awtoau/awto-cynthion-hardware/cynthion.kicad_pcb

## KiCad design cynthion.kicad_pcb (2026-07-26)

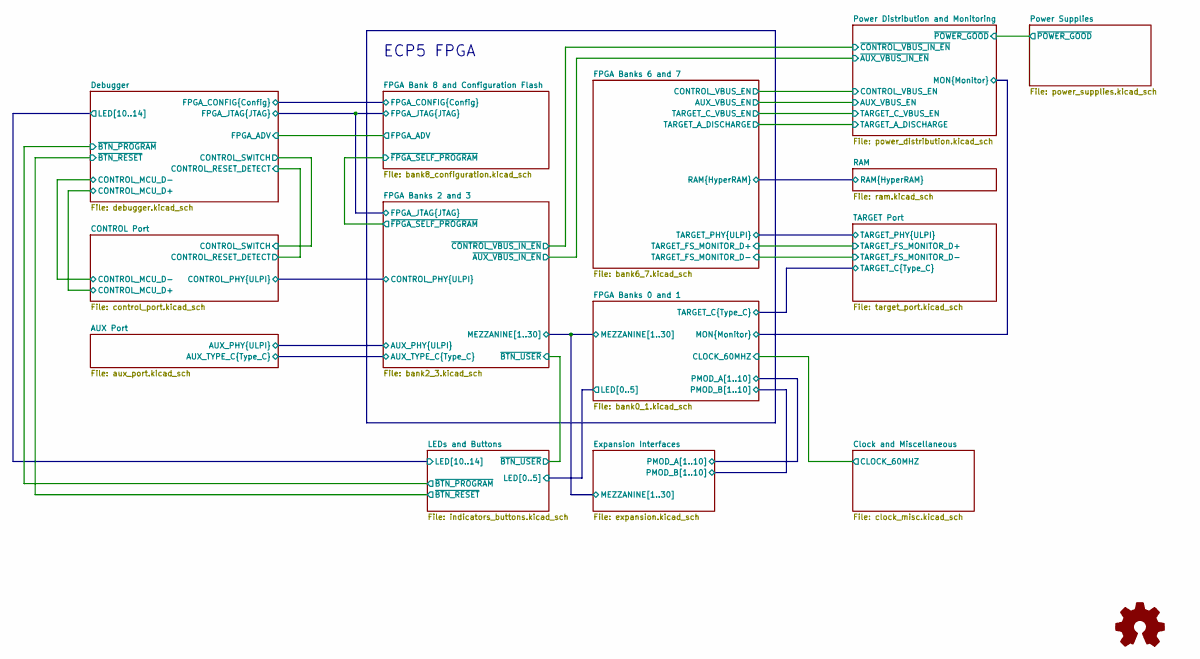
[picture p1: schematic cynthion.kicad_sch, ${TITLE}]

Notes on the sheet:
ECP5 FPGA

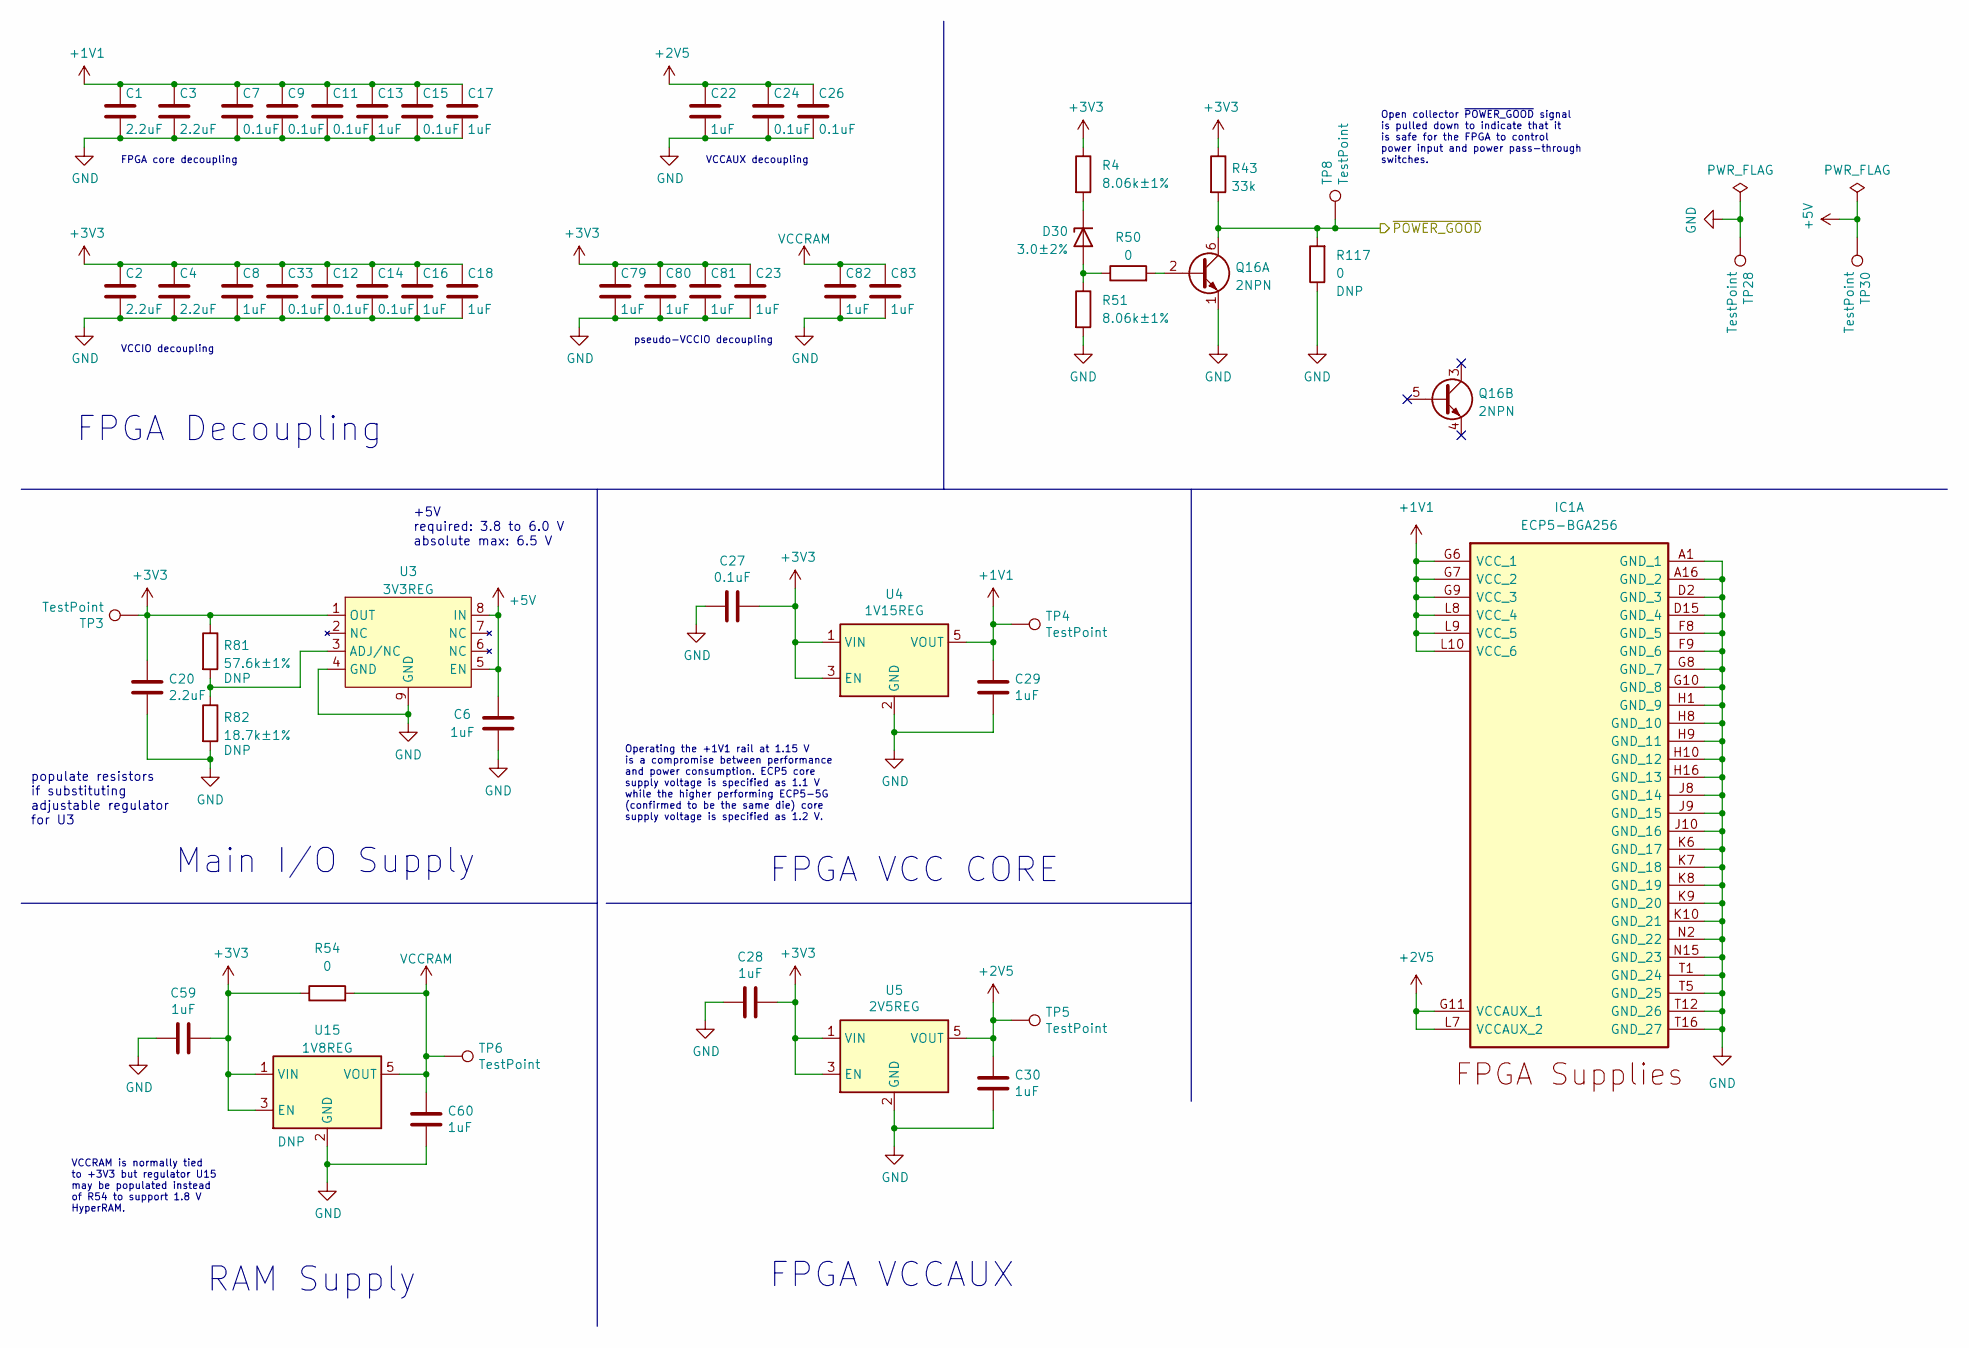
[picture p2: schematic power_supplies.kicad_sch, ${TITLE}]

Parts:
C1, C2, C3, C4, C20: 2.2uF; C_0603_1608Metric; Part Number CL10A225KP8NNNC
C6, C8, C13, C16, C17, C18, C22, C23, C28, C29, C30, C59, C60, C79, C80, C81, C82, C83: 1uF; C_0402_1005Metric; Part Number CL05A105MQ5NNNC
C7, C9, C11, C12, C14, C15, C24, C26, C27, C33: 0.1uF; C_0402_1005Metric; Part Number CL05A104KA5NNNC
D30: 3.0±2%; DFN1006-2; Part Number BZX884-B3V0,315
IC1: ECP5-BGA256; lattice_cabga256; Part Number LFE5U-12F-6BG256C
Q16: 2NPN; SOT-363_SC-70-6; Part Number BC847BS
R4, R51: 8.06k±1%; R_0402_1005Metric; Part Number ERJ-2RKF8061X
R43: 33k; R_0402_1005Metric; Part Number ERJ-2GEJ333X
R50, R54, R117: 0; R_0402_1005Metric; Part Number RC0402FR-070RL
R81: 57.6k±1%; R_0402_1005Metric; Part Number RC0402FR-0757K6L
R82: 18.7k±1%; R_0402_1005Metric; Part Number ERJ-2RKF1872X
TP3, TP4, TP5, TP6, TP8, TP28, TP30: TestPoint; TestPoint_Pad_D1.0mm
U3: 3V3REG; DFN-8-1EP_3x3mm_P0.65mm_EP1.55x2.4mm; Part Number AP7361EA-33FGE-7
U4: 1V15REG; SOT-23-5; Part Number TCR2EF115,LM(CT
U5: 2V5REG; SOT-23-5; Part Number MIC5504-2.5YM5-TR
U15: 1V8REG; SOT-23-5; Part Number MIC5504-1.8YM5-TR

Connections:
+1V1: C1.1, C3.1, C7.1, C9.1, C11.1, C13.1, C15.1, C17.1, C29.1, IC1.G6 (VCC_1), IC1.G7 (VCC_2), IC1.G9 (VCC_3), IC1.L8 (VCC_4), IC1.L9 (VCC_5), IC1.L10 (VCC_6), TP4.1 (1_1), U4.5 (VOUT)
+2V5: C22.1, C24.1, C26.1, C30.1, IC1.G11 (VCCAUX_1), IC1.L7 (VCCAUX_2), TP5.1 (1_1), U5.5 (VOUT)
+3V3: C2.1, C4.1, C8.1, C12.1, C14.1, C16.1, C18.1, C20.1, C23.1, C27.1, C28.1, C33.1, C59.1, C79.1, C80.1, C81.1, R4.1, R43.1, R54.1, R81.1, TP3.1 (1_1), U3.1 (OUT), U4.1 (VIN), U4.3 (EN), U5.1 (VIN), U5.3 (EN), U15.1 (VIN), U15.3 (EN); also elsewhere on the board
+5V: C6.1, TP30.1 (1_1), U3.5 (EN), U3.8 (IN); also elsewhere on the board
/Power Distribution and Monitoring/~POWER_GOOD: Q16.6 (C1), R43.2, R117.2, TP8.1 (1_1); also elsewhere on the board
GND: C1.2, C2.2, C3.2, C4.2, C6.2, C7.2, C8.2, C9.2, C11.2, C12.2, C13.2, C14.2, C15.2, C16.2, C17.2, C18.2, C20.2, C22.2, C23.2, C24.2, C26.2, C27.2, C28.2, C29.2, C30.2, C33.2, C59.2, C60.2, C79.2, C80.2, C81.2, C82.2, C83.2, IC1.A1 (GND_1), IC1.A16 (GND_2), IC1.D2 (GND_3), IC1.D15 (GND_4), IC1.F8 (GND_5), IC1.F9 (GND_6), IC1.G8 (GND_7), IC1.G10 (GND_8), IC1.H1 (GND_9), IC1.H8 (GND_10), IC1.H9 (GND_11), IC1.H10 (GND_12), IC1.H16 (GND_13), IC1.J8 (GND_14), IC1.J9 (GND_15), IC1.J10 (GND_16), IC1.K6 (GND_17), IC1.K7 (GND_18), IC1.K8 (GND_19), IC1.K9 (GND_20), IC1.K10 (GND_21), IC1.N2 (GND_22), IC1.N15 (GND_23), IC1.T1 (GND_24), IC1.T5 (GND_25), IC1.T12 (GND_26), IC1.T16 (GND_27), Q16.1 (E1), R51.2, R82.2, R117.1, TP28.1 (1_1), U3.4 (GND), U3.9 (GND), U4.2 (GND), U5.2 (GND), U15.2 (GND); also elsewhere on the board
unnamed: D30.2 (A), R50.1, R51.1
unnamed: D30.1 (K), R4.2
unnamed: Q16.2 (B1), R50.2
unnamed: R81.2, R82.1, U3.3 (ADJ/NC)
VCCRAM: C60.1, C82.1, C83.1, R54.2, TP6.1 (1_1), U15.5 (VOUT); also elsewhere on the board

Notes on the sheet:
VCCIO decoupling
FPGA VCC CORE
FPGA Decoupling
FPGA core decoupling
+5V required: 3.8 to 6.0 V absolute max: 6.5 V
VCCRAM is normally tied to +3V3 but regulator U15 may be populated instead of R54 to support 1.8 V HyperRAM.
Open collector ~{POWER_GOOD} signal is pulled down to indicate that it is safe for the FPGA to control power input and power pass-through switches.
VCCAUX decoupling
FPGA VCCAUX
Main I/O Supply
populate resistors if substituting adjustable regulator for U3
RAM Supply
Operating the +1V1 rail at 1.15 V is a compromise between performance and power consumption. ECP5 core supply voltage is specified as 1.1 V while the higher performing ECP5-5G (confirmed to be the same die) core supply voltage is specified as 1.2 V.
pseudo-VCCIO decoupling

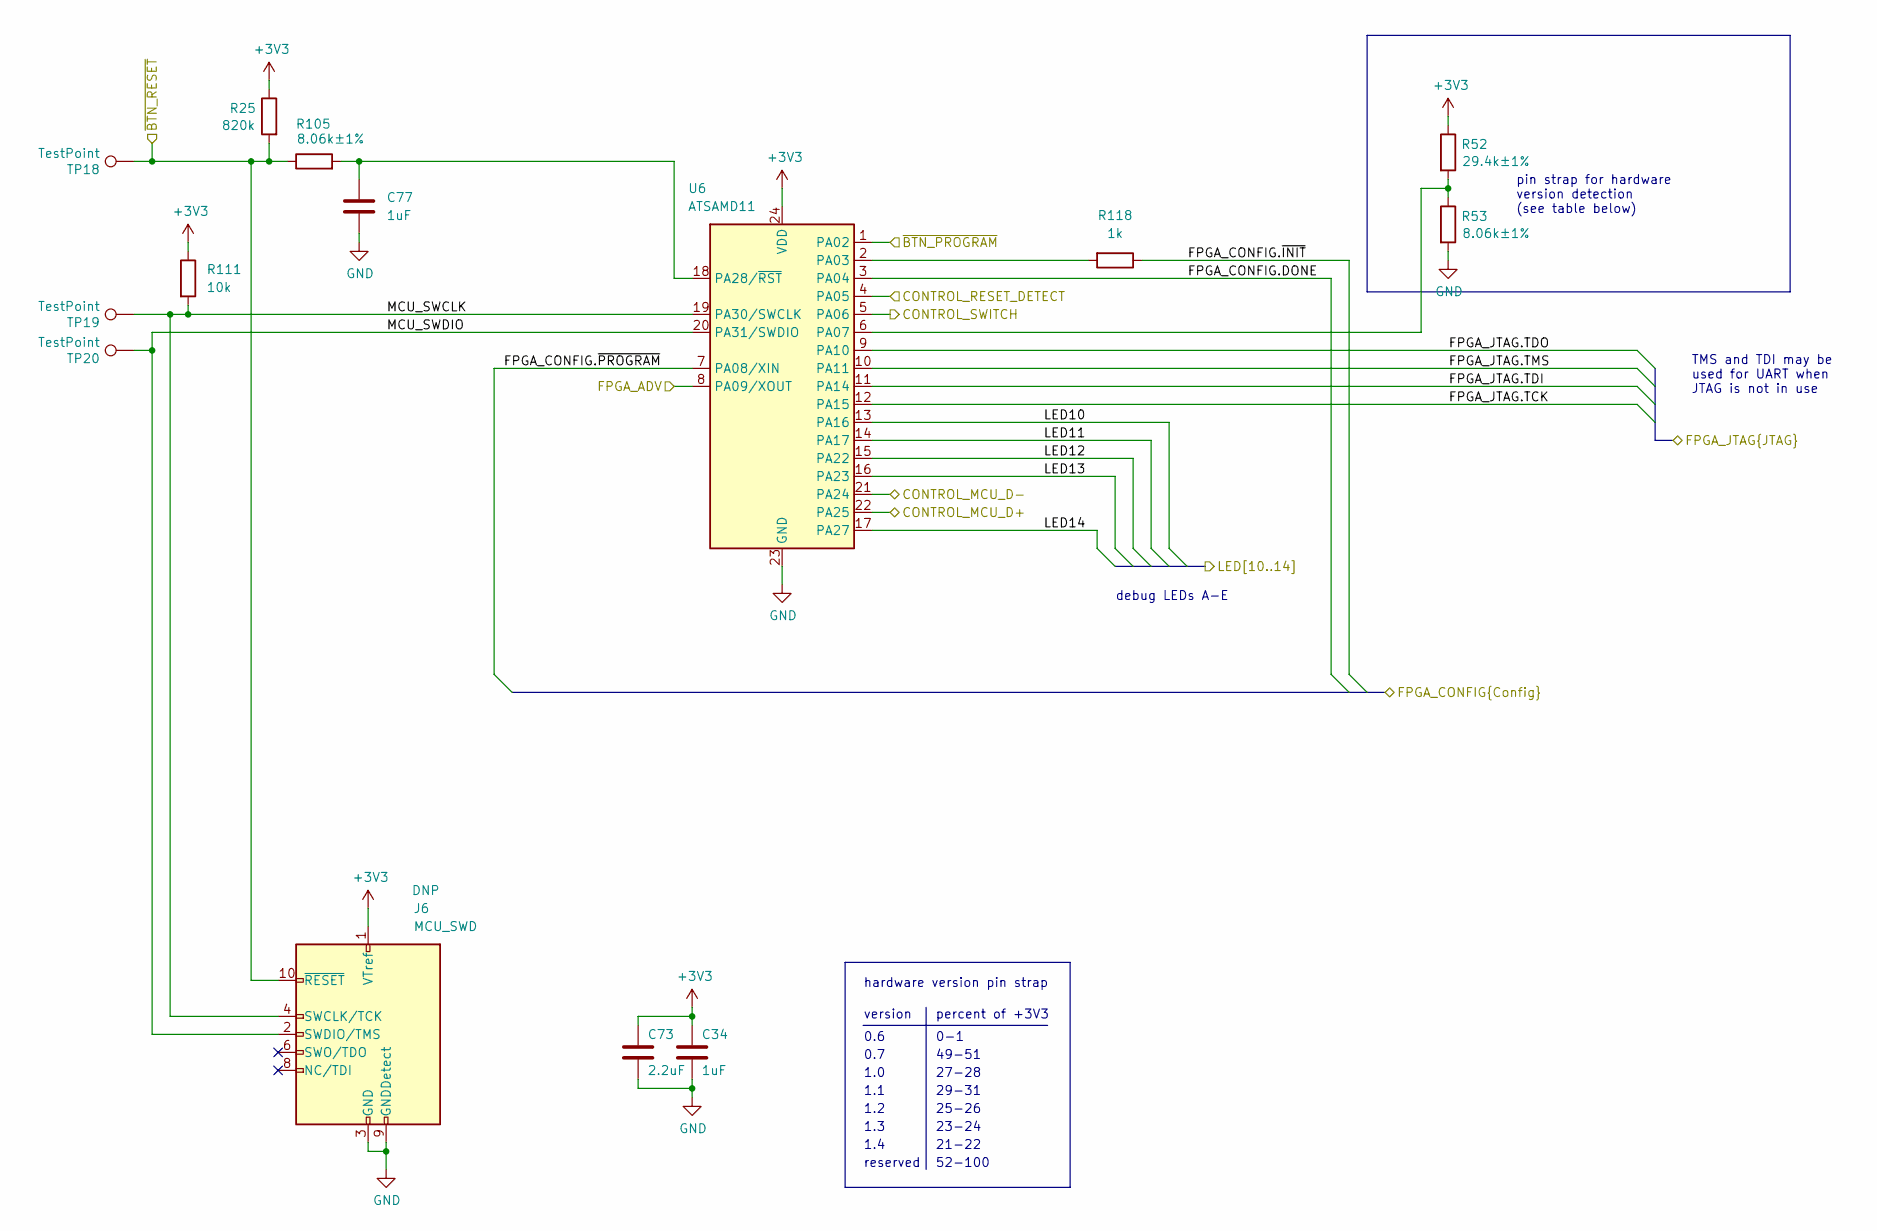
[picture p3: schematic debugger.kicad_sch, ${TITLE}]

Parts:
C34, C77: 1uF; C_0402_1005Metric; Part Number CL05A105MQ5NNNC
C73: 2.2uF; C_0603_1608Metric; Part Number CL10A225KP8NNNC
J6: MCU_SWD; SWD_CONNECTOR_LARGE_BOX; Part Number FTSH-105-01-F-D-K
R25: 820k; R_0402_1005Metric; Part Number RC0402JR-07820KL
R52: 29.4k±1%; R_0402_1005Metric; Part Number RC0402FR-0729K4L
R53, R105: 8.06k±1%; R_0402_1005Metric; Part Number ERJ-2RKF8061X
R111: 10k; R_0402_1005Metric; Part Number RC0402JR-0710KL
R118: 1k; R_0402_1005Metric; Part Number RC0402JR-071KL
TP18, TP19, TP20: TestPoint; TestPoint_Pad_D1.0mm
U6: ATSAMD11; QFN-24-1EP_4x4mm_P0.5mm_EP2.6x2.6mm; Part Number ATSAMD11D14A-MUT

Connections:
+3V3: C34.1, C73.1, J6.1 (VTref), R25.1, R52.1, R111.1, U6.24 (VDD); also elsewhere on the board
/CONTROL Port/CONTROL_MCU_D+: U6.22 (PA25); also elsewhere on the board
/CONTROL Port/CONTROL_MCU_D-: U6.21 (PA24); also elsewhere on the board
/CONTROL Port/CONTROL_RESET_DETECT: U6.4 (PA05); also elsewhere on the board
/CONTROL Port/CONTROL_SWITCH: U6.5 (PA06); also elsewhere on the board
/Debugger/FPGA_ADV: U6.8 (PA09/XOUT); also elsewhere on the board
/Debugger/FPGA_CONFIG.DONE: U6.3 (PA04); also elsewhere on the board
/Debugger/FPGA_CONFIG.~INIT: R118.1; also elsewhere on the board
/Debugger/FPGA_CONFIG.~PROGRAM: U6.7 (PA08/XIN); also elsewhere on the board
/Debugger/FPGA_JTAG.TCK: U6.12 (PA15); also elsewhere on the board
/Debugger/FPGA_JTAG.TDI: U6.11 (PA14); also elsewhere on the board
/Debugger/FPGA_JTAG.TDO: U6.9 (PA10); also elsewhere on the board
/Debugger/FPGA_JTAG.TMS: U6.10 (PA11); also elsewhere on the board
/Debugger/LED10: U6.13 (PA16); also elsewhere on the board
/Debugger/LED11: U6.14 (PA17); also elsewhere on the board
/Debugger/LED12: U6.15 (PA22); also elsewhere on the board
/Debugger/LED13: U6.16 (PA23); also elsewhere on the board
/Debugger/LED14: U6.17 (PA27); also elsewhere on the board
/Debugger/MCU_SWCLK: J6.4 (SWCLK/TCK), R111.2, TP19.1 (1_1), U6.19 (PA30/SWCLK)
/Debugger/MCU_SWDIO: J6.2 (SWDIO/TMS), TP20.1 (1_1), U6.20 (PA31/SWDIO)
/Debugger/~BTN_PROGRAM: U6.1 (PA02); also elsewhere on the board
/Debugger/~BTN_RESET: J6.10 (~RESET), R25.2, R105.1, TP18.1 (1_1); also elsewhere on the board
GND: C34.2, C73.2, C77.2, J6.3 (GND), J6.5 (GND), J6.9 (GNDDetect), R53.2, U6.23 (GND); also elsewhere on the board
unnamed: R118.2, U6.2 (PA03)
unnamed: R52.2, R53.1, U6.6 (PA07)
unnamed: C77.1, R105.2, U6.18 (PA28/~RST)

Notes on the sheet:
1.4
debug LEDs A-E
reserved
27-28
52-100
version
25-26
percent of +3V3
TMS and TDI may be used for UART when JTAG is not in use
29-31
0.6
0-1
1.0
23-24
pin strap for hardware version detection (see table below)
49-51
1.2
0.7
1.3
21-22
1.1
hardware version pin strap

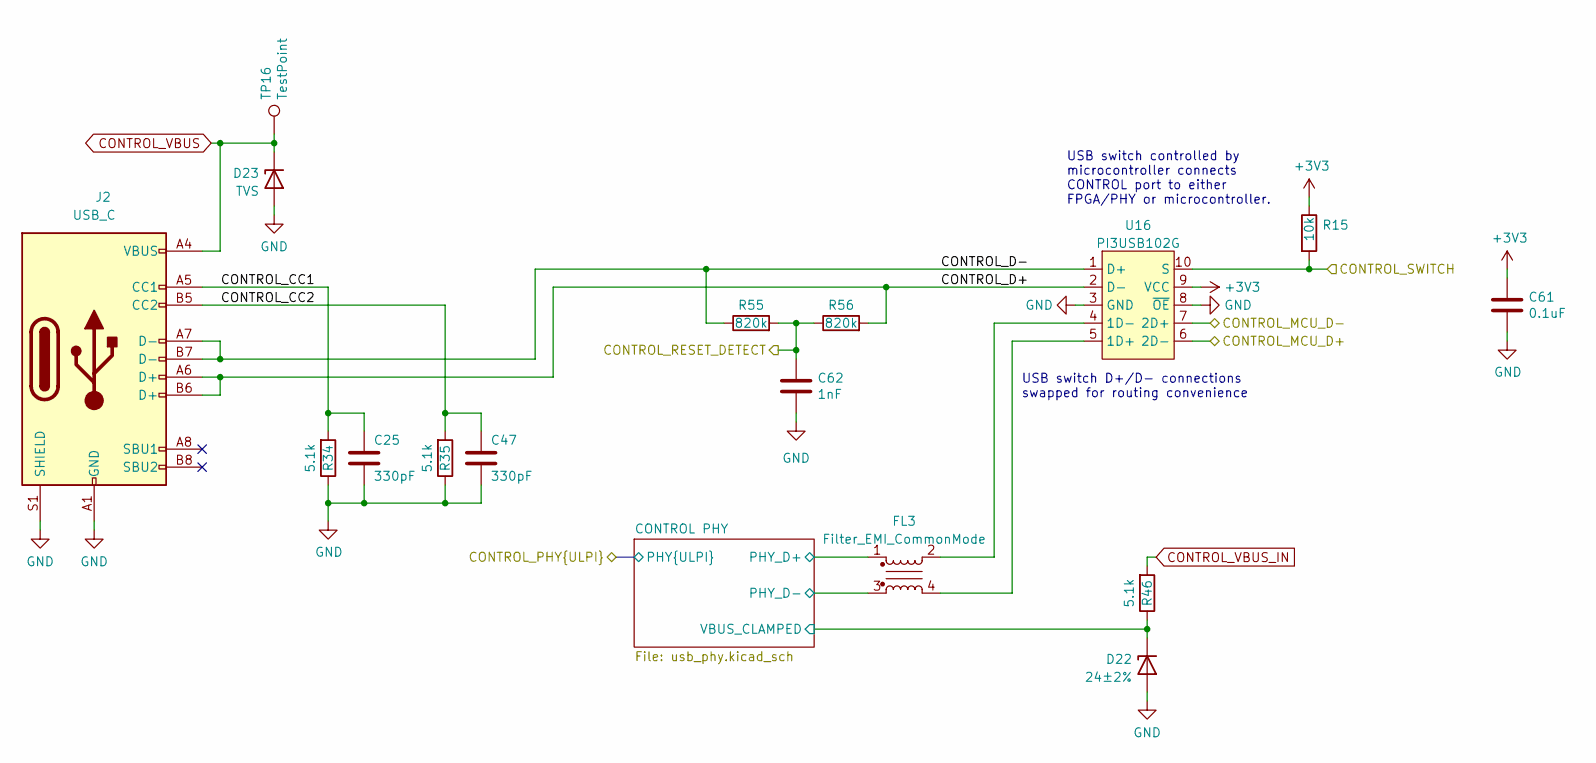
[picture p4: schematic control_port.kicad_sch, ${TITLE}]

Parts:
C25, C47: 330pF; C_0402_1005Metric; Part Number CL05C331JB5NNNC
C61: 0.1uF; C_0402_1005Metric; Part Number CL05A104KA5NNNC
C62: 1nF; C_0402_1005Metric; Part Number CL05B102KB5NNNC
D22: 24±2%; DFN1006-2; Part Number BZX884-B24,315
D23: TVS; DFN1006-2; Part Number PESD36VS1UL,315
FL3: Filter_EMI_CommonMode; L_CommonModeChoke_Murata_DLM0NS; Part Number DLM0NSB280HY2D
J2: USB_C; USB_C_Receptacle_HRO_TYPE-C-31-M-12; Part Number USB-TYPE-C-019
R15: 10k; R_0402_1005Metric; Part Number RC0402JR-0710KL
R34, R35, R46: 5.1k; R_0402_1005Metric; Part Number RC0402JR-075K1L
R55, R56: 820k; R_0402_1005Metric; Part Number RC0402JR-07820KL
TP16: TestPoint; TestPoint_Pad_D1.0mm
U16: PI3USB102G; Diodes_10-TQFN_ZL; Part Number PI3USB102GZLEX

Connections:
+3V3: C61.1, R15.1, U16.9 (VCC); also elsewhere on the board
/CONTROL Port/CONTROL PHY/PHY_D+: FL3.1; also elsewhere on the board
/CONTROL Port/CONTROL PHY/PHY_D-: FL3.3; also elsewhere on the board
/CONTROL Port/CONTROL PHY/VBUS_CLAMPED: D22.1 (K), R46.1; also elsewhere on the board
/CONTROL Port/CONTROL_CC1: C25.1, J2.A5 (CC1), R34.2
/CONTROL Port/CONTROL_CC2: C47.1, J2.B5 (CC2), R35.2
/CONTROL Port/CONTROL_D+: J2.A6 (D+), J2.B6 (D+), R56.2, U16.2 (D-)
/CONTROL Port/CONTROL_D-: J2.A7 (D-), J2.B7 (D-), R55.1, U16.1 (D+)
/CONTROL Port/CONTROL_MCU_D+: U16.6 (2D-); also elsewhere on the board
/CONTROL Port/CONTROL_MCU_D-: U16.7 (2D+); also elsewhere on the board
/CONTROL Port/CONTROL_RESET_DETECT: C62.1, R55.2, R56.1; also elsewhere on the board
/CONTROL Port/CONTROL_SWITCH: R15.2, U16.10 (S); also elsewhere on the board
CONTROL_VBUS: D23.1 (K), J2.A4 (VBUS), J2.A9 (VBUS), J2.B4 (VBUS), J2.B9 (VBUS), TP16.1 (1_1); also elsewhere on the board
CONTROL_VBUS_IN: R46.2; also elsewhere on the board
GND: C25.2, C47.2, C61.2, C62.2, D22.2 (A), D23.2 (A), J2.A1 (GND), J2.A12 (GND), J2.B1 (GND), J2.B12 (GND), J2.S1 (SHIELD), R34.1, R35.1, U16.3 (GND), U16.8 (~OE); also elsewhere on the board
unnamed: FL3.4, U16.5 (1D+)
unnamed: FL3.2, U16.4 (1D-)

Notes on the sheet:
USB switch controlled by microcontroller connects CONTROL port to either FPGA/PHY or microcontroller.
USB switch D+/D- connections swapped for routing convenience

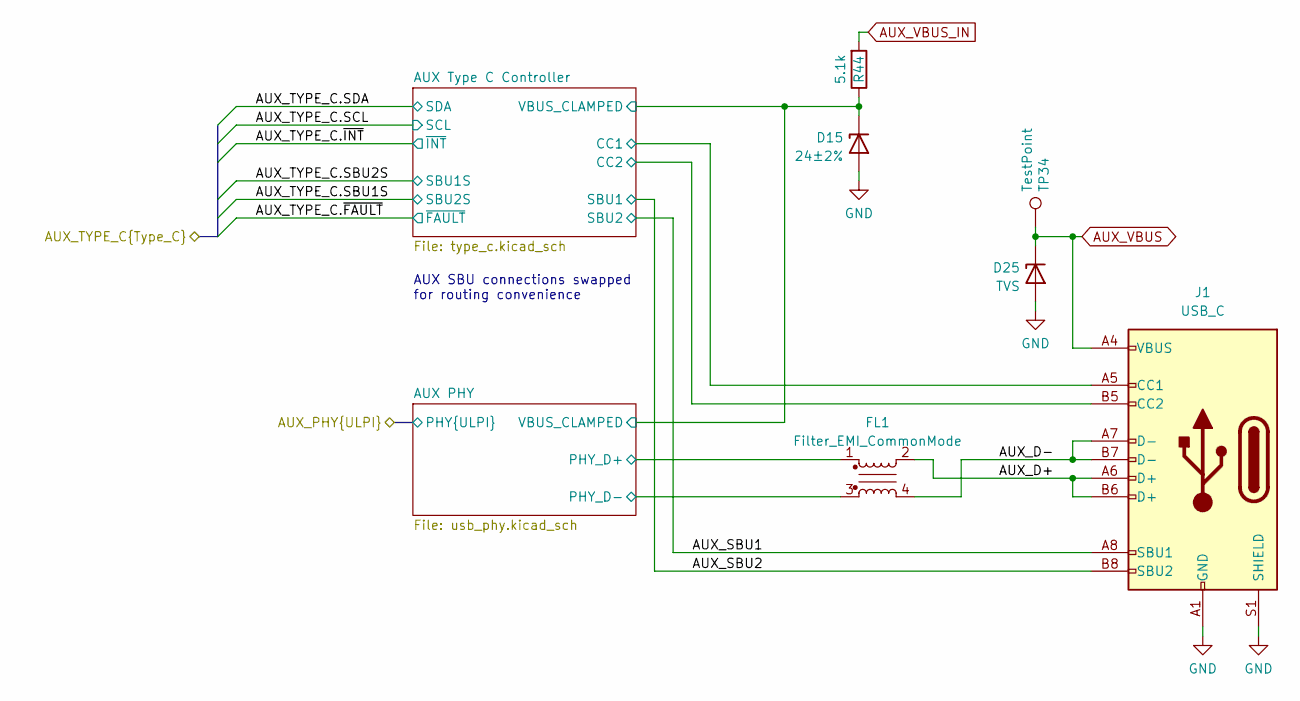
[picture p5: schematic aux_port.kicad_sch, ${TITLE}]

Parts:
D15: 24±2%; DFN1006-2; Part Number BZX884-B24,315
D25: TVS; DFN1006-2; Part Number PESD36VS1UL,315
FL1: Filter_EMI_CommonMode; L_CommonModeChoke_Murata_DLM0NS; Part Number DLM0NSB280HY2D
J1: USB_C; USB_C_Receptacle_HRO_TYPE-C-31-M-12; Part Number USB-TYPE-C-019
R44: 5.1k; R_0402_1005Metric; Part Number RC0402JR-075K1L
TP34: TestPoint; TestPoint_Pad_D1.0mm

Connections:
/AUX Port/AUX PHY/PHY_D+: FL1.1; also elsewhere on the board
/AUX Port/AUX PHY/PHY_D-: FL1.3; also elsewhere on the board
/AUX Port/AUX PHY/VBUS_CLAMPED: D15.1 (K), R44.1; also elsewhere on the board
/AUX Port/AUX Type C Controller/CC1: J1.A5 (CC1); also elsewhere on the board
/AUX Port/AUX Type C Controller/CC2: J1.B5 (CC2); also elsewhere on the board
/AUX Port/AUX_D+: FL1.2, J1.A6 (D+), J1.B6 (D+)
/AUX Port/AUX_D-: FL1.4, J1.A7 (D-), J1.B7 (D-)
/AUX Port/AUX_SBU1: J1.A8 (SBU1); also elsewhere on the board
/AUX Port/AUX_SBU2: J1.B8 (SBU2); also elsewhere on the board
AUX_VBUS: D25.1 (K), J1.A4 (VBUS), J1.A9 (VBUS), J1.B4 (VBUS), J1.B9 (VBUS), TP34.1 (1_1); also elsewhere on the board
AUX_VBUS_IN: R44.2; also elsewhere on the board
GND: D15.2 (A), D25.2 (A), J1.A1 (GND), J1.A12 (GND), J1.B1 (GND), J1.B12 (GND), J1.S1 (SHIELD); also elsewhere on the board

Notes on the sheet:
AUX SBU connections swapped for routing convenience

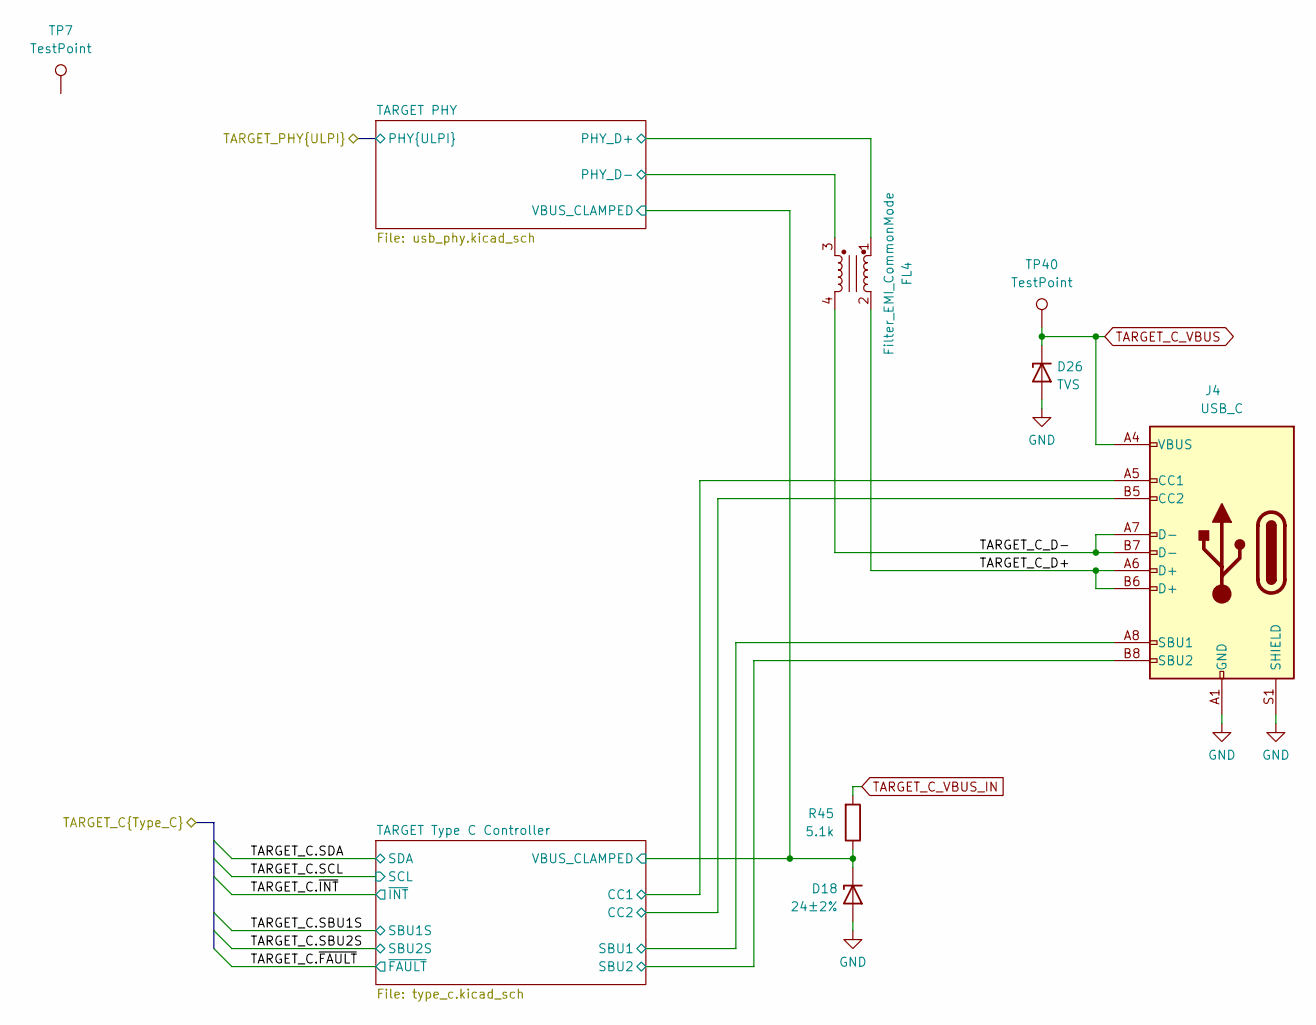
[picture p6: schematic target_port.kicad_sch, ${TITLE}]

Parts:
D18: 24±2%; DFN1006-2; Part Number BZX884-B24,315
D26: TVS; DFN1006-2; Part Number PESD36VS1UL,315
FL4: Filter_EMI_CommonMode; L_CommonModeChoke_Murata_DLM0NS; Part Number DLM0NSB280HY2D
J4: USB_C; USB_C_Receptacle_HRO_TYPE-C-31-M-12; Part Number USB-TYPE-C-019
R45: 5.1k; R_0402_1005Metric; Part Number RC0402JR-075K1L
TP7, TP40: TestPoint; TestPoint_Pad_D1.0mm

Connections:
/TARGET Port/TARGET PHY/PHY_D+: FL4.1; also elsewhere on the board
/TARGET Port/TARGET PHY/PHY_D-: FL4.3; also elsewhere on the board
/TARGET Port/TARGET PHY/VBUS_CLAMPED: D18.1 (K), R45.1; also elsewhere on the board
/TARGET Port/TARGET Type C Controller/CC1: J4.A5 (CC1); also elsewhere on the board
/TARGET Port/TARGET Type C Controller/CC2: J4.B5 (CC2); also elsewhere on the board
/TARGET Port/TARGET Type C Controller/SBU1: J4.A8 (SBU1); also elsewhere on the board
/TARGET Port/TARGET Type C Controller/SBU2: J4.B8 (SBU2); also elsewhere on the board
/TARGET Port/TARGET_C_D+: FL4.2, J4.A6 (D+), J4.B6 (D+)
/TARGET Port/TARGET_C_D-: FL4.4, J4.A7 (D-), J4.B7 (D-)
GND: D18.2 (A), D26.2 (A), J4.A1 (GND), J4.A12 (GND), J4.B1 (GND), J4.B12 (GND), J4.S1 (SHIELD); also elsewhere on the board
TARGET_C_VBUS: D26.1 (K), J4.A4 (VBUS), J4.A9 (VBUS), J4.B4 (VBUS), J4.B9 (VBUS), TP40.1 (1_1); also elsewhere on the board
TARGET_C_VBUS_IN: R45.2; also elsewhere on the board

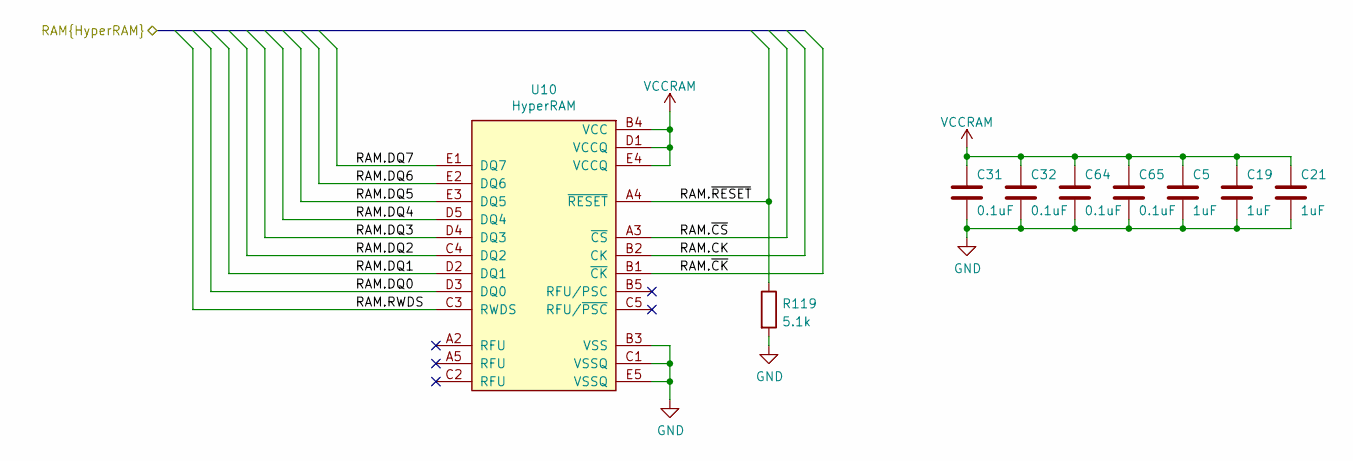
[picture p7: schematic ram.kicad_sch, ${TITLE}]

Parts:
C5, C19, C21: 1uF; C_0402_1005Metric; Part Number CL05A105MQ5NNNC
C31, C32, C64, C65: 0.1uF; C_0402_1005Metric; Part Number CL05A104KA5NNNC
R119: 5.1k; R_0402_1005Metric; Part Number RC0402JR-075K1L
U10: HyperRAM; BGA-24_5x5_6.0x8.0mm; Part Number W956A8MBYA6I

Connections:
/FPGA Banks 6 and 7/RAM.CK: U10.B2 (CK); also elsewhere on the board
/FPGA Banks 6 and 7/RAM.DQ0: U10.D3 (DQ0); also elsewhere on the board
/FPGA Banks 6 and 7/RAM.DQ1: U10.D2 (DQ1); also elsewhere on the board
/FPGA Banks 6 and 7/RAM.DQ2: U10.C4 (DQ2); also elsewhere on the board
/FPGA Banks 6 and 7/RAM.DQ3: U10.D4 (DQ3); also elsewhere on the board
/FPGA Banks 6 and 7/RAM.DQ4: U10.D5 (DQ4); also elsewhere on the board
/FPGA Banks 6 and 7/RAM.DQ5: U10.E3 (DQ5); also elsewhere on the board
/FPGA Banks 6 and 7/RAM.DQ6: U10.E2 (DQ6); also elsewhere on the board
/FPGA Banks 6 and 7/RAM.DQ7: U10.E1 (DQ7); also elsewhere on the board
/FPGA Banks 6 and 7/RAM.RWDS: U10.C3 (RWDS); also elsewhere on the board
/FPGA Banks 6 and 7/RAM.~CK: U10.B1 (~CK); also elsewhere on the board
/FPGA Banks 6 and 7/RAM.~CS: U10.A3 (~CS); also elsewhere on the board
/FPGA Banks 6 and 7/RAM.~RESET: R119.1, U10.A4 (~RESET); also elsewhere on the board
GND: C5.2, C19.2, C21.2, C31.2, C32.2, C64.2, C65.2, R119.2, U10.B3 (VSS), U10.C1 (VSSQ), U10.E5 (VSSQ); also elsewhere on the board
VCCRAM: C5.1, C19.1, C21.1, C31.1, C32.1, C64.1, C65.1, U10.B4 (VCC), U10.D1 (VCCQ), U10.E4 (VCCQ); also elsewhere on the board

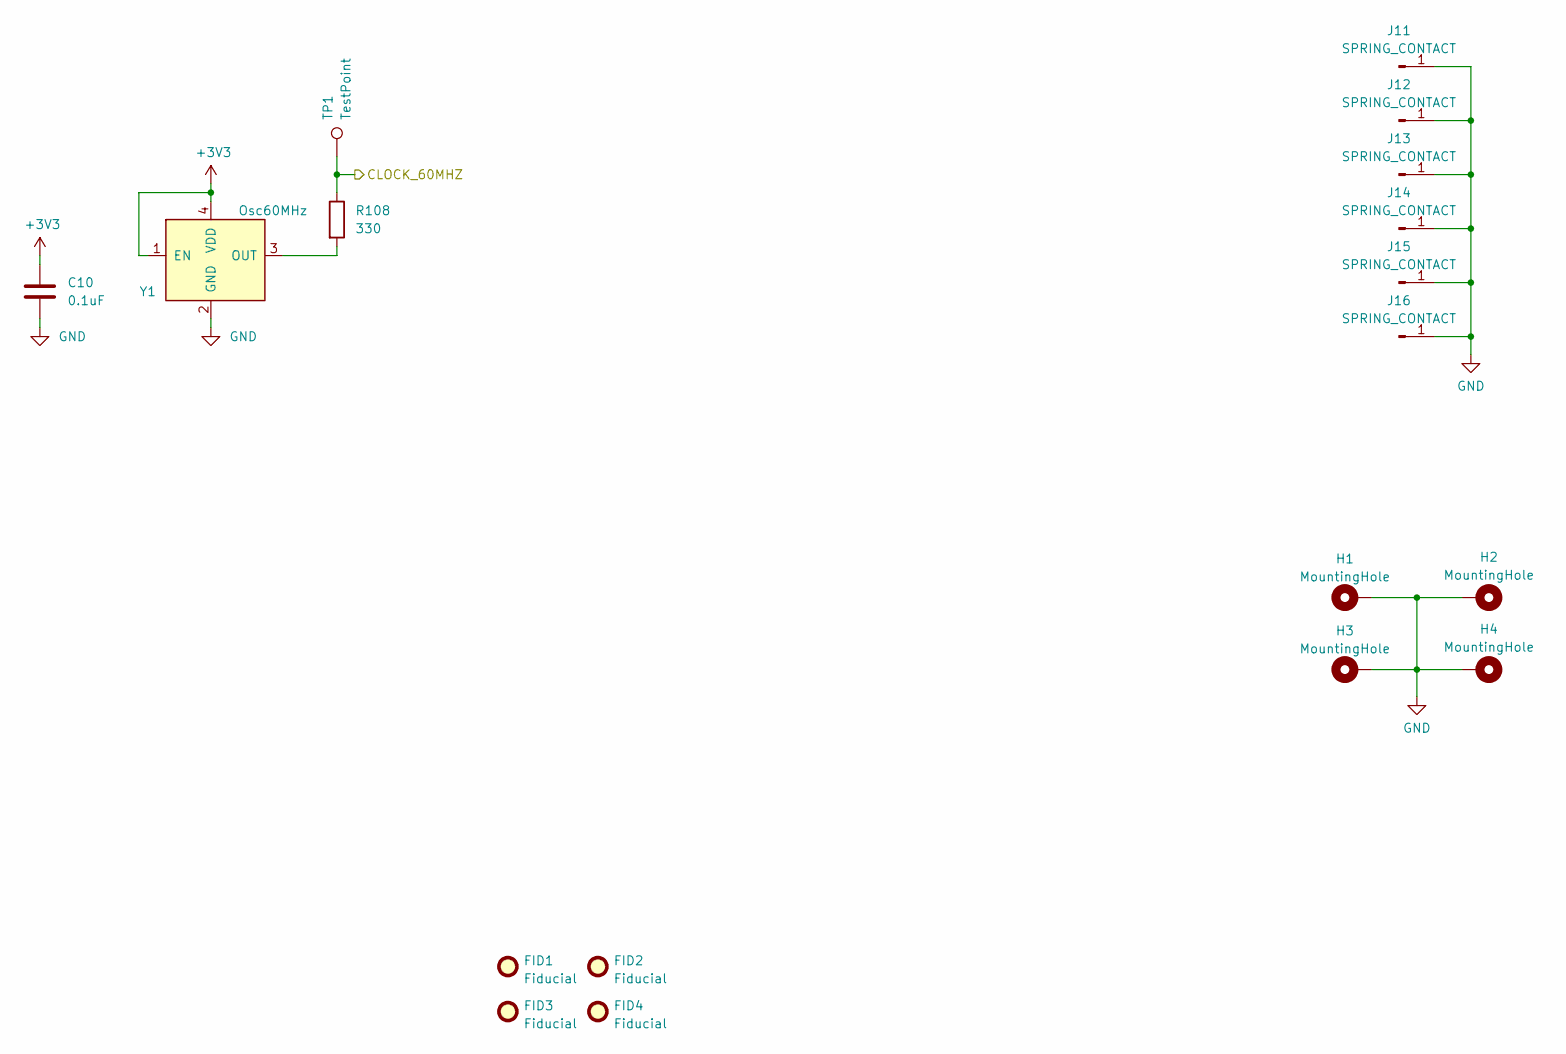
[picture p8: schematic clock_misc.kicad_sch, ${TITLE}]

Parts:
C10: 0.1uF; C_0402_1005Metric; Part Number CL05A104KA5NNNC
FID1, FID2, FID3, FID4: Fiducial; Fiducial_0.5mm_Mask1mm
H1, H2, H3, H4: MountingHole; MountingHole_2.2mm_M2_Pad_Via
J11, J12, J13, J14, J15, J16: SPRING_CONTACT; BW0033AG-L3.4W0.9H1.8; Part Number BW0033AG-L3.4W0.9H1.8
R108: 330; R_0402_1005Metric; Part Number RC0402FR-13330RL
TP1: TestPoint; TestPoint_Pad_D1.0mm
Y1: Osc60MHz; Crystal_SMD_3225-4Pin_3.2x2.5mm; Part Number SIT1602BC-23-33E-60.000000E

Connections:
+3V3: C10.1, Y1.1 (EN), Y1.4 (VDD); also elsewhere on the board
/Clock and Miscellaneous/CLOCK_60MHZ: R108.1, TP1.1 (1_1); also elsewhere on the board
GND: C10.2, H1.1 (1_1), H2.1 (1_1), H3.1 (1_1), H4.1 (1_1), J11.1 (Pin_1_1), J12.1 (Pin_1_1), J13.1 (Pin_1_1), J14.1 (Pin_1_1), J15.1 (Pin_1_1), J16.1 (Pin_1_1), Y1.2 (GND); also elsewhere on the board
unnamed: R108.2, Y1.3 (OUT)

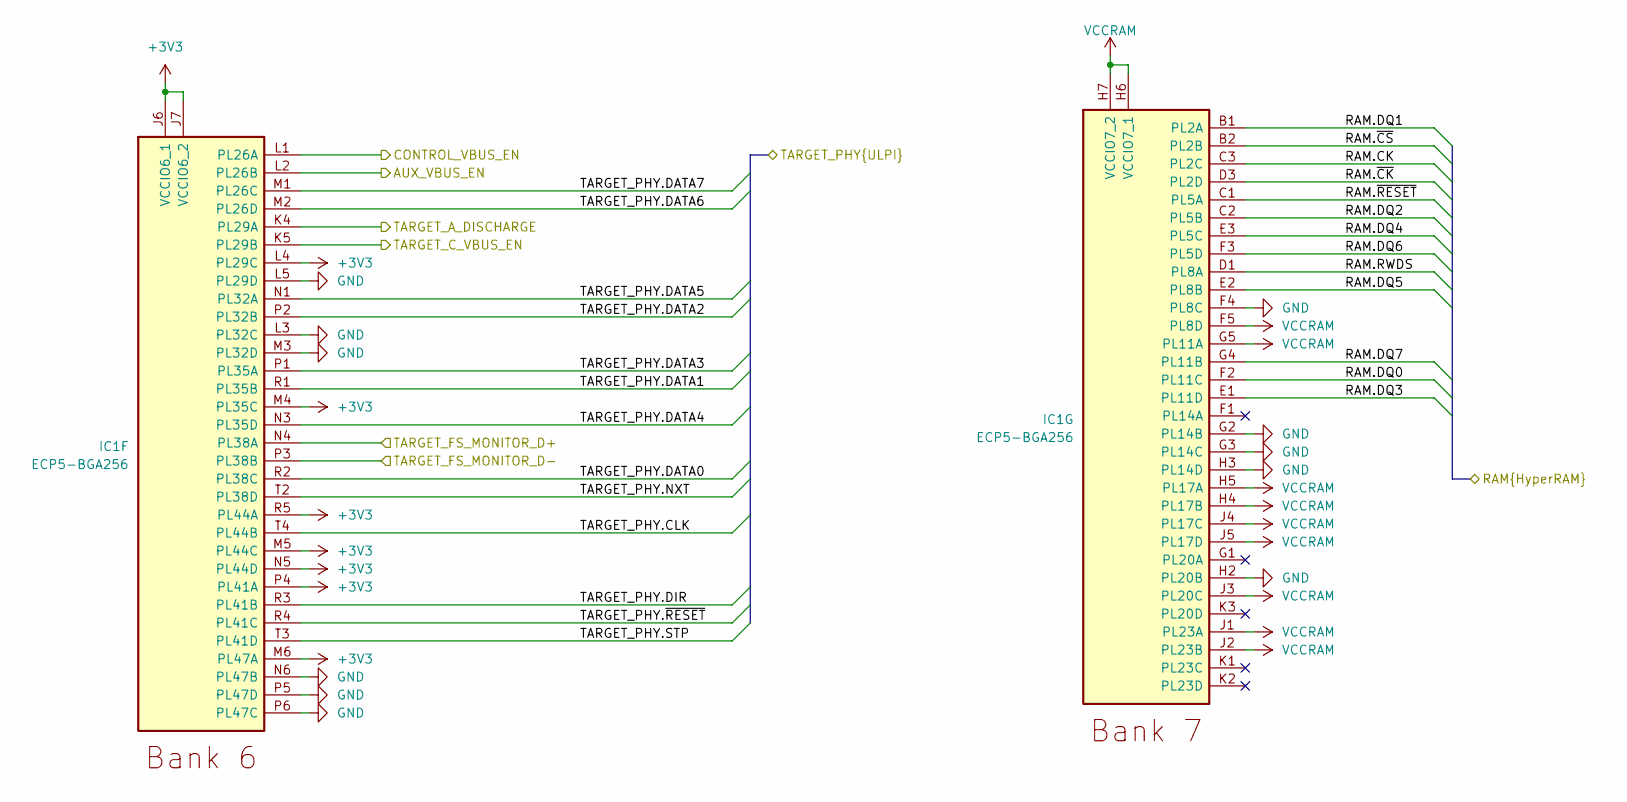
[picture p9: schematic bank6_7.kicad_sch, ${TITLE}]

Parts:
IC1: ECP5-BGA256; lattice_cabga256; Part Number LFE5U-12F-6BG256C

Connections:
+3V3: IC1.J6 (VCCIO6_1), IC1.J7 (VCCIO6_2), IC1.L4 (PL29C), IC1.M4 (PL35C), IC1.M5 (PL44C), IC1.M6 (PL47A), IC1.N5 (PL44D), IC1.P4 (PL41A), IC1.R5 (PL44A); also elsewhere on the board
/FPGA Banks 6 and 7/AUX_VBUS_EN: IC1.L2 (PL26B); also elsewhere on the board
/FPGA Banks 6 and 7/CONTROL_VBUS_EN: IC1.L1 (PL26A); also elsewhere on the board
/FPGA Banks 6 and 7/RAM.CK: IC1.C3 (PL2C); also elsewhere on the board
/FPGA Banks 6 and 7/RAM.DQ0: IC1.F2 (PL11C); also elsewhere on the board
/FPGA Banks 6 and 7/RAM.DQ1: IC1.B1 (PL2A); also elsewhere on the board
/FPGA Banks 6 and 7/RAM.DQ2: IC1.C2 (PL5B); also elsewhere on the board
/FPGA Banks 6 and 7/RAM.DQ3: IC1.E1 (PL11D); also elsewhere on the board
/FPGA Banks 6 and 7/RAM.DQ4: IC1.E3 (PL5C); also elsewhere on the board
/FPGA Banks 6 and 7/RAM.DQ5: IC1.E2 (PL8B); also elsewhere on the board
/FPGA Banks 6 and 7/RAM.DQ6: IC1.F3 (PL5D); also elsewhere on the board
/FPGA Banks 6 and 7/RAM.DQ7: IC1.G4 (PL11B); also elsewhere on the board
/FPGA Banks 6 and 7/RAM.RWDS: IC1.D1 (PL8A); also elsewhere on the board
/FPGA Banks 6 and 7/RAM.~CK: IC1.D3 (PL2D); also elsewhere on the board
/FPGA Banks 6 and 7/RAM.~CS: IC1.B2 (PL2B); also elsewhere on the board
/FPGA Banks 6 and 7/RAM.~RESET: IC1.C1 (PL5A); also elsewhere on the board
/FPGA Banks 6 and 7/TARGET_A_DISCHARGE: IC1.K4 (PL29A); also elsewhere on the board
/FPGA Banks 6 and 7/TARGET_C_VBUS_EN: IC1.K5 (PL29B); also elsewhere on the board
/FPGA Banks 6 and 7/TARGET_FS_MONITOR_D+: IC1.N4 (PL38A)
/FPGA Banks 6 and 7/TARGET_FS_MONITOR_D-: IC1.P3 (PL38B)
/FPGA Banks 6 and 7/TARGET_PHY.CLK: IC1.T4 (PL44B); also elsewhere on the board
/FPGA Banks 6 and 7/TARGET_PHY.DATA0: IC1.R2 (PL38C); also elsewhere on the board
/FPGA Banks 6 and 7/TARGET_PHY.DATA1: IC1.R1 (PL35B); also elsewhere on the board
/FPGA Banks 6 and 7/TARGET_PHY.DATA2: IC1.P2 (PL32B); also elsewhere on the board
/FPGA Banks 6 and 7/TARGET_PHY.DATA3: IC1.P1 (PL35A); also elsewhere on the board
/FPGA Banks 6 and 7/TARGET_PHY.DATA4: IC1.N3 (PL35D); also elsewhere on the board
/FPGA Banks 6 and 7/TARGET_PHY.DATA5: IC1.N1 (PL32A); also elsewhere on the board
/FPGA Banks 6 and 7/TARGET_PHY.DATA6: IC1.M2 (PL26D); also elsewhere on the board
/FPGA Banks 6 and 7/TARGET_PHY.DATA7: IC1.M1 (PL26C); also elsewhere on the board
/FPGA Banks 6 and 7/TARGET_PHY.DIR: IC1.R3 (PL41B); also elsewhere on the board
/FPGA Banks 6 and 7/TARGET_PHY.NXT: IC1.T2 (PL38D); also elsewhere on the board
/FPGA Banks 6 and 7/TARGET_PHY.STP: IC1.T3 (PL41D); also elsewhere on the board
/FPGA Banks 6 and 7/TARGET_PHY.~RESET: IC1.R4 (PL41C); also elsewhere on the board
GND: IC1.F4 (PL8C), IC1.G2 (PL14B), IC1.G3 (PL14C), IC1.H2 (PL20B), IC1.H3 (PL14D), IC1.L3 (PL32C), IC1.L5 (PL29D), IC1.M3 (PL32D), IC1.N6 (PL47B), IC1.P5 (PL47D), IC1.P6 (PL47C); also elsewhere on the board
VCCRAM: IC1.F5 (PL8D), IC1.G5 (PL11A), IC1.H4 (PL17B), IC1.H5 (PL17A), IC1.H6 (VCCIO7_1), IC1.H7 (VCCIO7_2), IC1.J1 (PL23A), IC1.J2 (PL23B), IC1.J3 (PL20C), IC1.J4 (PL17C), IC1.J5 (PL17D); also elsewhere on the board
