awtoau/awto-cynthion-hardware/cynthion.kicad_pcb

## KiCad design cynthion.kicad_pcb (continued)

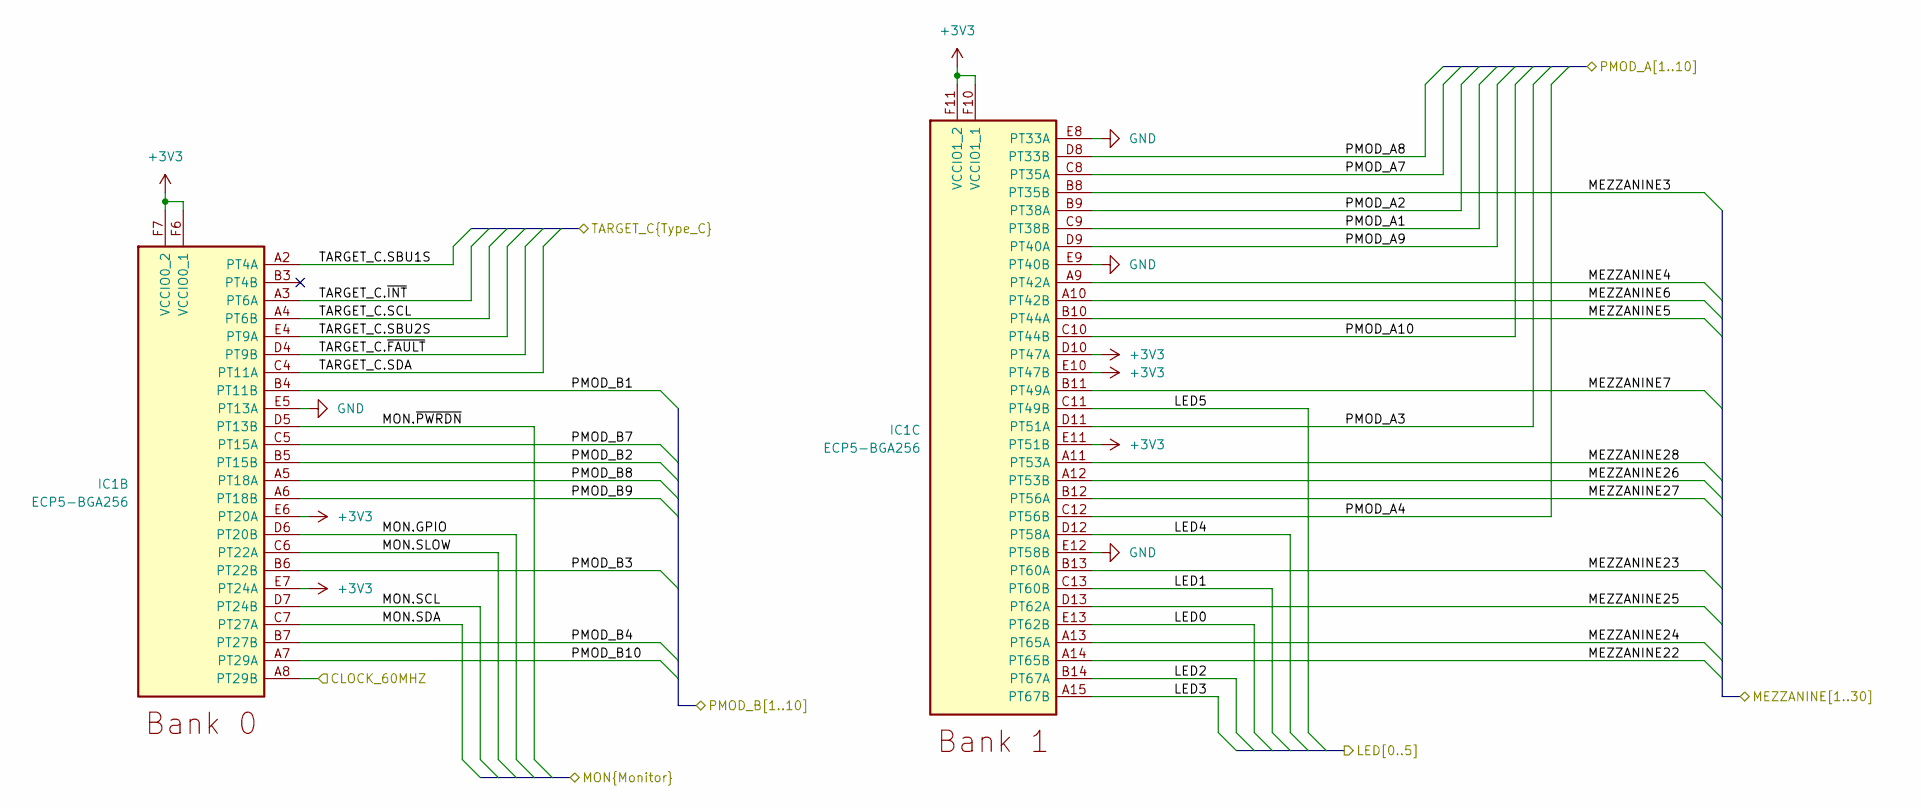
[picture p14: schematic bank0_1.kicad_sch, ${TITLE}]

Parts:
IC1: ECP5-BGA256; lattice_cabga256; Part Number LFE5U-12F-6BG256C

Connections:
+3V3: IC1.D10 (PT47A), IC1.E6 (PT20A), IC1.E7 (PT24A), IC1.E10 (PT47B), IC1.E11 (PT51B), IC1.F6 (VCCIO0_1), IC1.F7 (VCCIO0_2), IC1.F10 (VCCIO1_1), IC1.F11 (VCCIO1_2); also elsewhere on the board
/Clock and Miscellaneous/CLOCK_60MHZ: IC1.A8 (PT29B); also elsewhere on the board
/Expansion Interfaces/MEZZANINE3: IC1.B8 (PT35B); also elsewhere on the board
/Expansion Interfaces/MEZZANINE4: IC1.A9 (PT42A); also elsewhere on the board
/Expansion Interfaces/MEZZANINE5: IC1.B10 (PT44A); also elsewhere on the board
/Expansion Interfaces/MEZZANINE6: IC1.A10 (PT42B); also elsewhere on the board
/Expansion Interfaces/MEZZANINE7: IC1.B11 (PT49A); also elsewhere on the board
/Expansion Interfaces/MEZZANINE22: IC1.A14 (PT65B); also elsewhere on the board
/Expansion Interfaces/MEZZANINE23: IC1.B13 (PT60A); also elsewhere on the board
/Expansion Interfaces/MEZZANINE24: IC1.A13 (PT65A); also elsewhere on the board
/Expansion Interfaces/MEZZANINE25: IC1.D13 (PT62A); also elsewhere on the board
/Expansion Interfaces/MEZZANINE26: IC1.A12 (PT53B); also elsewhere on the board
/Expansion Interfaces/MEZZANINE27: IC1.B12 (PT56A); also elsewhere on the board
/Expansion Interfaces/MEZZANINE28: IC1.A11 (PT53A); also elsewhere on the board
/Expansion Interfaces/PMOD_A1: IC1.C9 (PT38B); also elsewhere on the board
/Expansion Interfaces/PMOD_A2: IC1.B9 (PT38A); also elsewhere on the board
/Expansion Interfaces/PMOD_A3: IC1.D11 (PT51A); also elsewhere on the board
/Expansion Interfaces/PMOD_A4: IC1.C12 (PT56B); also elsewhere on the board
/Expansion Interfaces/PMOD_A7: IC1.C8 (PT35A); also elsewhere on the board
/Expansion Interfaces/PMOD_A8: IC1.D8 (PT33B); also elsewhere on the board
/Expansion Interfaces/PMOD_A9: IC1.D9 (PT40A); also elsewhere on the board
/Expansion Interfaces/PMOD_A10: IC1.C10 (PT44B); also elsewhere on the board
/Expansion Interfaces/PMOD_B1: IC1.B4 (PT11B); also elsewhere on the board
/Expansion Interfaces/PMOD_B2: IC1.B5 (PT15B); also elsewhere on the board
/Expansion Interfaces/PMOD_B3: IC1.B6 (PT22B); also elsewhere on the board
/Expansion Interfaces/PMOD_B4: IC1.B7 (PT27B); also elsewhere on the board
/Expansion Interfaces/PMOD_B7: IC1.C5 (PT15A); also elsewhere on the board
/Expansion Interfaces/PMOD_B8: IC1.A5 (PT18A); also elsewhere on the board
/Expansion Interfaces/PMOD_B9: IC1.A6 (PT18B); also elsewhere on the board
/Expansion Interfaces/PMOD_B10: IC1.A7 (PT29A); also elsewhere on the board
/FPGA Banks 0 and 1/LED0: IC1.E13 (PT62B); also elsewhere on the board
/FPGA Banks 0 and 1/LED1: IC1.C13 (PT60B); also elsewhere on the board
/FPGA Banks 0 and 1/LED2: IC1.B14 (PT67A); also elsewhere on the board
/FPGA Banks 0 and 1/LED3: IC1.A15 (PT67B); also elsewhere on the board
/FPGA Banks 0 and 1/LED4: IC1.D12 (PT58A); also elsewhere on the board
/FPGA Banks 0 and 1/LED5: IC1.C11 (PT49B); also elsewhere on the board
/FPGA Banks 0 and 1/MON.GPIO: IC1.D6 (PT20B); also elsewhere on the board
/FPGA Banks 0 and 1/MON.SCL: IC1.D7 (PT24B); also elsewhere on the board
/FPGA Banks 0 and 1/MON.SDA: IC1.C7 (PT27A); also elsewhere on the board
/FPGA Banks 0 and 1/MON.SLOW: IC1.C6 (PT22A); also elsewhere on the board
/FPGA Banks 0 and 1/MON.~PWRDN: IC1.D5 (PT13B); also elsewhere on the board
/FPGA Banks 0 and 1/TARGET_C.SBU1S: IC1.A2 (PT4A); also elsewhere on the board
/FPGA Banks 0 and 1/TARGET_C.SBU2S: IC1.E4 (PT9A); also elsewhere on the board
/FPGA Banks 0 and 1/TARGET_C.SCL: IC1.A4 (PT6B); also elsewhere on the board
/FPGA Banks 0 and 1/TARGET_C.SDA: IC1.C4 (PT11A); also elsewhere on the board
/FPGA Banks 0 and 1/TARGET_C.~FAULT: IC1.D4 (PT9B); also elsewhere on the board
/FPGA Banks 0 and 1/TARGET_C.~INT: IC1.A3 (PT6A); also elsewhere on the board
GND: IC1.E5 (PT13A), IC1.E8 (PT33A), IC1.E9 (PT40B), IC1.E12 (PT58B); also elsewhere on the board

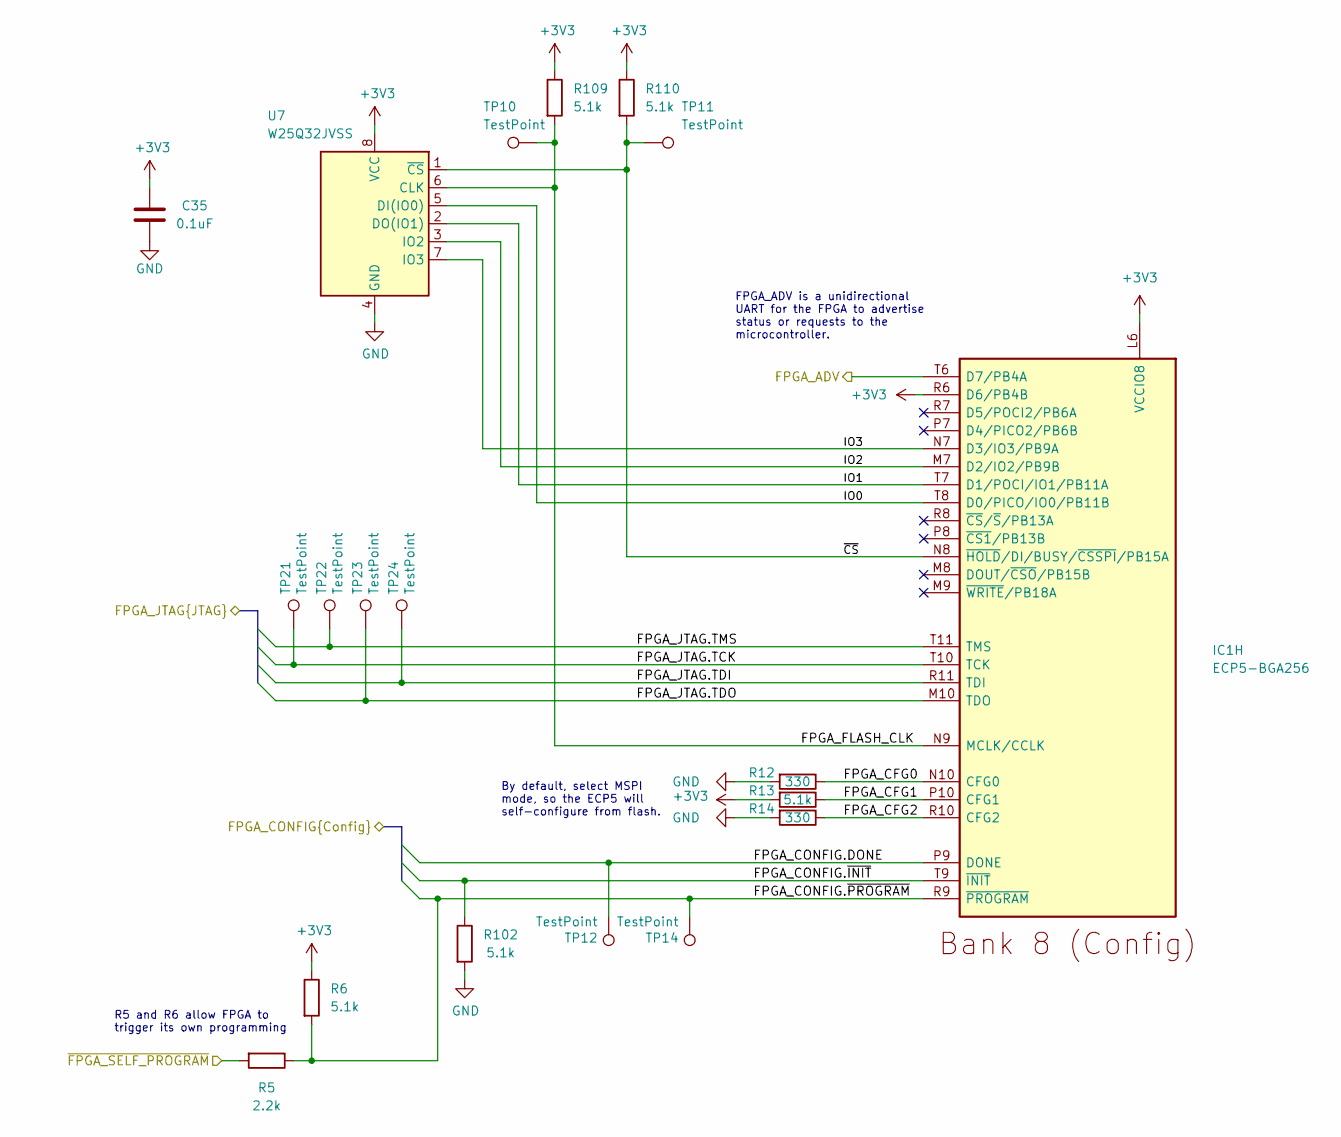
[picture p15: schematic bank8_configuration.kicad_sch, ${TITLE}]

Parts:
C35: 0.1uF; C_0402_1005Metric; Part Number CL05A104KA5NNNC
IC1: ECP5-BGA256; lattice_cabga256; Part Number LFE5U-12F-6BG256C
R5: 2.2k; R_0402_1005Metric; Part Number RC0402JR-072K2L
R6, R13, R102, R109, R110: 5.1k; R_0402_1005Metric; Part Number RC0402JR-075K1L
R12, R14: 330; R_0402_1005Metric; Part Number RC0402FR-13330RL
TP10, TP11, TP12, TP14, TP21, TP22, TP23, TP24: TestPoint; TestPoint_Pad_D1.0mm
U7: W25Q32JVSS; SOIC-8_5.23x5.23mm_P1.27mm; Part Number W25Q32JVSSIQ

Connections:
+3V3: C35.1, IC1.L6 (VCCIO8), IC1.R6 (D6/PB4B), R6.1, R13.2, R109.1, R110.1, U7.8 (VCC); also elsewhere on the board
/Debugger/FPGA_ADV: IC1.T6 (D7/PB4A); also elsewhere on the board
/Debugger/FPGA_CONFIG.DONE: IC1.P9 (DONE), TP12.1 (1_1); also elsewhere on the board
/Debugger/FPGA_CONFIG.~INIT: IC1.T9 (~INIT), R102.1; also elsewhere on the board
/Debugger/FPGA_CONFIG.~PROGRAM: IC1.R9 (~PROGRAM), R5.1, R6.2, TP14.1 (1_1); also elsewhere on the board
/Debugger/FPGA_JTAG.TCK: IC1.T10 (TCK), TP21.1 (1_1); also elsewhere on the board
/Debugger/FPGA_JTAG.TDI: IC1.R11 (TDI), TP24.1 (1_1); also elsewhere on the board
/Debugger/FPGA_JTAG.TDO: IC1.M10 (TDO), TP23.1 (1_1); also elsewhere on the board
/Debugger/FPGA_JTAG.TMS: IC1.T11 (TMS), TP22.1 (1_1); also elsewhere on the board
/FPGA Bank 8 and Configuration Flash/FPGA_CFG0: IC1.N10 (CFG0), R12.1
/FPGA Bank 8 and Configuration Flash/FPGA_CFG1: IC1.P10 (CFG1), R13.1
/FPGA Bank 8 and Configuration Flash/FPGA_CFG2: IC1.R10 (CFG2), R14.1
/FPGA Bank 8 and Configuration Flash/FPGA_FLASH_CLK: IC1.N9 (MCLK/CCLK), R109.2, TP10.1 (1_1), U7.6 (CLK)
/FPGA Bank 8 and Configuration Flash/IO0: IC1.T8 (D0/PICO/IO0/PB11B), U7.5 (DI(IO0))
/FPGA Bank 8 and Configuration Flash/IO1: IC1.T7 (D1/POCI/IO1/PB11A), U7.2 (DO(IO1))
/FPGA Bank 8 and Configuration Flash/IO2: IC1.M7 (D2/IO2/PB9B), U7.3 (IO2)
/FPGA Bank 8 and Configuration Flash/IO3: IC1.N7 (D3/IO3/PB9A), U7.7 (IO3)
/FPGA Bank 8 and Configuration Flash/~CS: IC1.N8 (~HOLD/DI/BUSY/~CSSPI/PB15A), R110.2, TP11.1 (1_1), U7.1 (~CS)
/FPGA Bank 8 and Configuration Flash/~FPGA_SELF_PROGRAM: R5.2; also elsewhere on the board
GND: C35.2, R12.2, R14.2, R102.2, U7.4 (GND); also elsewhere on the board

Notes on the sheet:
By default, select MSPI mode, so the ECP5 will self-configure from flash.
FPGA_ADV is a unidirectional UART for the FPGA to advertise status or requests to the microcontroller.
R5 and R6 allow FPGA to trigger its own programming

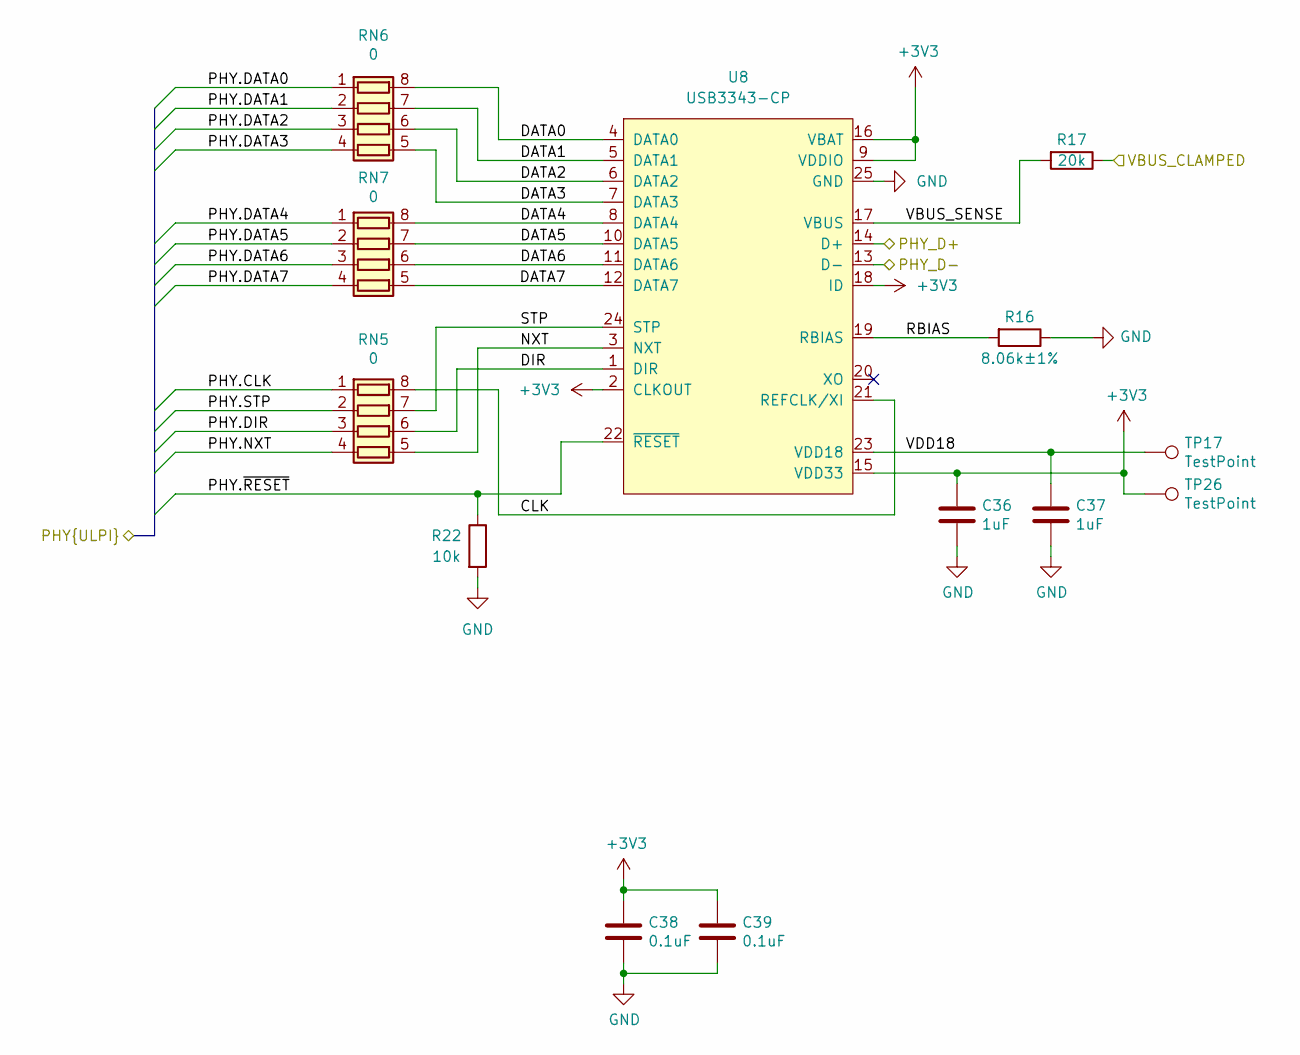
[picture p16: schematic usb_phy.kicad_sch, ${TITLE}]

Parts:
C36, C37: 1uF; C_0402_1005Metric; Part Number CL05A105MQ5NNNC
C38, C39: 0.1uF; C_0402_1005Metric; Part Number CL05A104KA5NNNC
R16: 8.06k±1%; R_0402_1005Metric; Part Number ERJ-2RKF8061X
R17: 20k; R_0402_1005Metric; Part Number RC0402JR-0720KL
R22: 10k; R_0402_1005Metric; Part Number RC0402JR-0710KL
RN5, RN6, RN7: 0; R_Array_Convex_4x0402; Part Number YC124-JR-070RL
TP17, TP26: TestPoint; TestPoint_Pad_D1.0mm
U8: USB3343-CP; VQFN-24-1EP_4x4mm_P0.5mm_EP2.45x2.45mm; Part Number USB3343-CP

Connections:
+3V3: C36.1, C38.1, C39.1, TP26.1 (1_1), U8.2 (CLKOUT), U8.9 (VDDIO), U8.15 (VDD33), U8.16 (VBAT), U8.18 (ID); also elsewhere on the board
/CONTROL Port/CONTROL PHY/CLK: RN5.8 (R1.2), U8.21 (REFCLK/XI)
/CONTROL Port/CONTROL PHY/DATA0: RN6.8 (R1.2), U8.4 (DATA0)
/CONTROL Port/CONTROL PHY/DATA1: RN6.7 (R2.2), U8.5 (DATA1)
/CONTROL Port/CONTROL PHY/DATA2: RN6.6 (R3.2), U8.6 (DATA2)
/CONTROL Port/CONTROL PHY/DATA3: RN6.5 (R4.2), U8.7 (DATA3)
/CONTROL Port/CONTROL PHY/DATA4: RN7.8 (R1.2), U8.8 (DATA4)
/CONTROL Port/CONTROL PHY/DATA5: RN7.7 (R2.2), U8.10 (DATA5)
/CONTROL Port/CONTROL PHY/DATA6: RN7.6 (R3.2), U8.11 (DATA6)
/CONTROL Port/CONTROL PHY/DATA7: RN7.5 (R4.2), U8.12 (DATA7)
/CONTROL Port/CONTROL PHY/DIR: RN5.6 (R3.2), U8.1 (DIR)
/CONTROL Port/CONTROL PHY/NXT: RN5.5 (R4.2), U8.3 (NXT)
/CONTROL Port/CONTROL PHY/PHY_D+: U8.14 (D+); also elsewhere on the board
/CONTROL Port/CONTROL PHY/PHY_D-: U8.13 (D-); also elsewhere on the board
/CONTROL Port/CONTROL PHY/RBIAS: R16.2, U8.19 (RBIAS)
/CONTROL Port/CONTROL PHY/STP: RN5.7 (R2.2), U8.24 (STP)
/CONTROL Port/CONTROL PHY/VBUS_CLAMPED: R17.1; also elsewhere on the board
/CONTROL Port/CONTROL PHY/VBUS_SENSE: R17.2, U8.17 (VBUS)
/CONTROL Port/CONTROL PHY/VDD18: C37.1, TP17.1 (1_1), U8.23 (VDD18)
/CONTROL Port/CONTROL_PHY.CLK: RN5.1 (R1.1); also elsewhere on the board
/CONTROL Port/CONTROL_PHY.DATA0: RN6.1 (R1.1); also elsewhere on the board
/CONTROL Port/CONTROL_PHY.DATA1: RN6.2 (R2.1); also elsewhere on the board
/CONTROL Port/CONTROL_PHY.DATA2: RN6.3 (R3.1); also elsewhere on the board
/CONTROL Port/CONTROL_PHY.DATA3: RN6.4 (R4.1); also elsewhere on the board
/CONTROL Port/CONTROL_PHY.DATA4: RN7.1 (R1.1); also elsewhere on the board
/CONTROL Port/CONTROL_PHY.DATA5: RN7.2 (R2.1); also elsewhere on the board
/CONTROL Port/CONTROL_PHY.DATA6: RN7.3 (R3.1); also elsewhere on the board
/CONTROL Port/CONTROL_PHY.DATA7: RN7.4 (R4.1); also elsewhere on the board
/CONTROL Port/CONTROL_PHY.DIR: RN5.3 (R3.1); also elsewhere on the board
/CONTROL Port/CONTROL_PHY.NXT: RN5.4 (R4.1); also elsewhere on the board
/CONTROL Port/CONTROL_PHY.STP: RN5.2 (R2.1); also elsewhere on the board
/CONTROL Port/CONTROL_PHY.~RESET: R22.1, U8.22 (~RESET); also elsewhere on the board
GND: C36.2, C37.2, C38.2, C39.2, R16.1, R22.2, U8.25 (GND); also elsewhere on the board

Parts of its further copies:
C42, C43, C48, C50: 1uF; C_0402_1005Metric; Part Number CL05A105MQ5NNNC
C44, C46, C66, C67: 0.1uF; C_0402_1005Metric; Part Number CL05A104KA5NNNC
R18, R20: 8.06k±1%; R_0402_1005Metric; Part Number ERJ-2RKF8061X
R19, R21: 20k; R_0402_1005Metric; Part Number RC0402JR-0720KL
R23, R24: 10k; R_0402_1005Metric; Part Number RC0402JR-0710KL
RN8, RN9, RN10, RN11, RN12, RN13: 0; R_Array_Convex_4x0402; Part Number YC124-JR-070RL
TP2, TP9, TP27, TP35: TestPoint; TestPoint_Pad_D1.0mm
U9, U11: USB3343-CP; VQFN-24-1EP_4x4mm_P0.5mm_EP2.45x2.45mm; Part Number USB3343-CP

Connections of its further copies:
+3V3: C42.1, C44.1, C46.1, C48.1, C66.1, C67.1, TP2.1 (1_1), TP9.1 (1_1), U9.2 (CLKOUT), U9.9 (VDDIO), U9.15 (VDD33), U9.16 (VBAT), U9.18 (ID), U11.2 (CLKOUT), U11.9 (VDDIO), U11.15 (VDD33), U11.16 (VBAT), U11.18 (ID); also elsewhere on the board
/AUX Port/AUX PHY/CLK: RN8.8 (R1.2), U11.21 (REFCLK/XI)
/AUX Port/AUX PHY/DATA0: RN9.8 (R1.2), U11.4 (DATA0)
/AUX Port/AUX PHY/DATA1: RN9.7 (R2.2), U11.5 (DATA1)
/AUX Port/AUX PHY/DATA2: RN9.6 (R3.2), U11.6 (DATA2)
/AUX Port/AUX PHY/DATA3: RN9.5 (R4.2), U11.7 (DATA3)
/AUX Port/AUX PHY/DATA4: RN10.8 (R1.2), U11.8 (DATA4)
/AUX Port/AUX PHY/DATA5: RN10.7 (R2.2), U11.10 (DATA5)
/AUX Port/AUX PHY/DATA6: RN10.6 (R3.2), U11.11 (DATA6)
/AUX Port/AUX PHY/DATA7: RN10.5 (R4.2), U11.12 (DATA7)
/AUX Port/AUX PHY/DIR: RN8.6 (R3.2), U11.1 (DIR)
/AUX Port/AUX PHY/NXT: RN8.5 (R4.2), U11.3 (NXT)
/AUX Port/AUX PHY/PHY_D+: U11.14 (D+); also elsewhere on the board
/AUX Port/AUX PHY/PHY_D-: U11.13 (D-); also elsewhere on the board
/AUX Port/AUX PHY/RBIAS: R20.2, U11.19 (RBIAS)
/AUX Port/AUX PHY/STP: RN8.7 (R2.2), U11.24 (STP)
/AUX Port/AUX PHY/VBUS_CLAMPED: R21.1; also elsewhere on the board
/AUX Port/AUX PHY/VBUS_SENSE: R21.2, U11.17 (VBUS)
/AUX Port/AUX PHY/VDD18: C50.1, TP35.1 (1_1), U11.23 (VDD18)
/AUX Port/AUX_PHY.CLK: RN8.1 (R1.1); also elsewhere on the board
/AUX Port/AUX_PHY.DATA0: RN9.1 (R1.1); also elsewhere on the board
/AUX Port/AUX_PHY.DATA1: RN9.2 (R2.1); also elsewhere on the board
/AUX Port/AUX_PHY.DATA2: RN9.3 (R3.1); also elsewhere on the board
/AUX Port/AUX_PHY.DATA3: RN9.4 (R4.1); also elsewhere on the board
/AUX Port/AUX_PHY.DATA4: RN10.1 (R1.1); also elsewhere on the board
/AUX Port/AUX_PHY.DATA5: RN10.2 (R2.1); also elsewhere on the board
/AUX Port/AUX_PHY.DATA6: RN10.3 (R3.1); also elsewhere on the board
/AUX Port/AUX_PHY.DATA7: RN10.4 (R4.1); also elsewhere on the board
/AUX Port/AUX_PHY.DIR: RN8.3 (R3.1); also elsewhere on the board
/AUX Port/AUX_PHY.NXT: RN8.4 (R4.1); also elsewhere on the board
/AUX Port/AUX_PHY.STP: RN8.2 (R2.1); also elsewhere on the board
/AUX Port/AUX_PHY.~RESET: R24.1, U11.22 (~RESET); also elsewhere on the board
/FPGA Banks 6 and 7/TARGET_PHY.CLK: RN11.1 (R1.1); also elsewhere on the board
/FPGA Banks 6 and 7/TARGET_PHY.DATA0: RN12.1 (R1.1); also elsewhere on the board
/FPGA Banks 6 and 7/TARGET_PHY.DATA1: RN12.2 (R2.1); also elsewhere on the board
/FPGA Banks 6 and 7/TARGET_PHY.DATA2: RN12.3 (R3.1); also elsewhere on the board
/FPGA Banks 6 and 7/TARGET_PHY.DATA3: RN12.4 (R4.1); also elsewhere on the board
/FPGA Banks 6 and 7/TARGET_PHY.DATA4: RN13.1 (R1.1); also elsewhere on the board
/FPGA Banks 6 and 7/TARGET_PHY.DATA5: RN13.2 (R2.1); also elsewhere on the board
/FPGA Banks 6 and 7/TARGET_PHY.DATA6: RN13.3 (R3.1); also elsewhere on the board
/FPGA Banks 6 and 7/TARGET_PHY.DATA7: RN13.4 (R4.1); also elsewhere on the board
/FPGA Banks 6 and 7/TARGET_PHY.DIR: RN11.3 (R3.1); also elsewhere on the board
/FPGA Banks 6 and 7/TARGET_PHY.NXT: RN11.4 (R4.1); also elsewhere on the board
/FPGA Banks 6 and 7/TARGET_PHY.STP: RN11.2 (R2.1); also elsewhere on the board
/FPGA Banks 6 and 7/TARGET_PHY.~RESET: R23.1, U9.22 (~RESET); also elsewhere on the board
/TARGET Port/TARGET PHY/CLK: RN11.8 (R1.2), U9.21 (REFCLK/XI)
/TARGET Port/TARGET PHY/DATA0: RN12.8 (R1.2), U9.4 (DATA0)
/TARGET Port/TARGET PHY/DATA1: RN12.7 (R2.2), U9.5 (DATA1)
/TARGET Port/TARGET PHY/DATA2: RN12.6 (R3.2), U9.6 (DATA2)
/TARGET Port/TARGET PHY/DATA3: RN12.5 (R4.2), U9.7 (DATA3)
/TARGET Port/TARGET PHY/DATA4: RN13.8 (R1.2), U9.8 (DATA4)
/TARGET Port/TARGET PHY/DATA5: RN13.7 (R2.2), U9.10 (DATA5)
/TARGET Port/TARGET PHY/DATA6: RN13.6 (R3.2), U9.11 (DATA6)
/TARGET Port/TARGET PHY/DATA7: RN13.5 (R4.2), U9.12 (DATA7)
/TARGET Port/TARGET PHY/DIR: RN11.6 (R3.2), U9.1 (DIR)
/TARGET Port/TARGET PHY/NXT: RN11.5 (R4.2), U9.3 (NXT)
/TARGET Port/TARGET PHY/PHY_D+: U9.14 (D+); also elsewhere on the board
/TARGET Port/TARGET PHY/PHY_D-: U9.13 (D-); also elsewhere on the board
/TARGET Port/TARGET PHY/RBIAS: R18.2, U9.19 (RBIAS)
/TARGET Port/TARGET PHY/STP: RN11.7 (R2.2), U9.24 (STP)
/TARGET Port/TARGET PHY/VBUS_CLAMPED: R19.1; also elsewhere on the board
/TARGET Port/TARGET PHY/VBUS_SENSE: R19.2, U9.17 (VBUS)
/TARGET Port/TARGET PHY/VDD18: C43.1, TP27.1 (1_1), U9.23 (VDD18)
GND: C42.2, C43.2, C44.2, C46.2, C48.2, C50.2, C66.2, C67.2, R18.1, R20.1, R23.2, R24.2, U9.25 (GND), U11.25 (GND); also elsewhere on the board

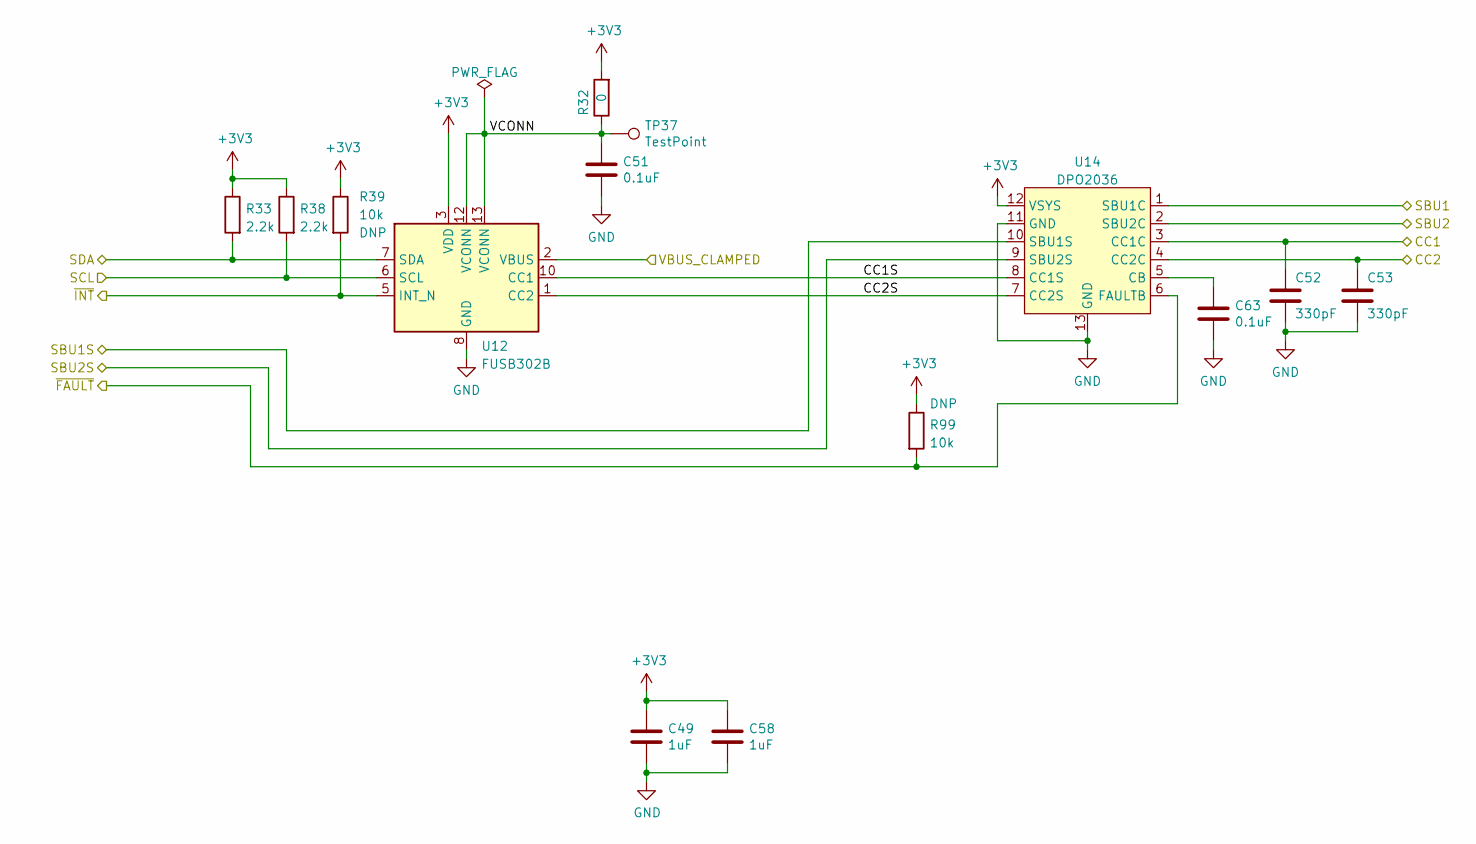
[picture p17: schematic type_c.kicad_sch, ${TITLE}]

Parts:
C49, C58: 1uF; C_0402_1005Metric; Part Number CL05A105MQ5NNNC
C51, C63: 0.1uF; C_0402_1005Metric; Part Number CL05A104KA5NNNC
C52, C53: 330pF; C_0402_1005Metric; Part Number CL05C331JB5NNNC
R32: 0; R_0402_1005Metric; Part Number RC0402FR-070RL
R33, R38: 2.2k; R_0402_1005Metric; Part Number RC0402JR-072K2L
R39, R99: 10k; R_0402_1005Metric; Part Number RC0402JR-0710KL
TP37: TestPoint; TestPoint_Pad_D1.0mm
U12: FUSB302B; WQFN-14-1EP_2.5x2.5mm_P0.5mm_EP1.45x1.45mm; Part Number FUSB302BMPX
U14: DPO2036; Diodes_UQFN2020-12_Type-B; Part Number DPO2036DBB-7

Connections:
+3V3: C49.1, C58.1, R32.2, R33.1, R38.1, R39.1, R99.1, U12.3 (VDD), U12.4 (VDD), U14.12 (VSYS); also elsewhere on the board
/AUX Port/AUX PHY/VBUS_CLAMPED: U12.2 (VBUS); also elsewhere on the board
/AUX Port/AUX Type C Controller/CC1: C52.1, U14.3 (CC1C); also elsewhere on the board
/AUX Port/AUX Type C Controller/CC1S: U12.10 (CC1), U12.11 (CC1), U14.8 (CC1S)
/AUX Port/AUX Type C Controller/CC2: C53.1, U14.4 (CC2C); also elsewhere on the board
/AUX Port/AUX Type C Controller/CC2S: U12.1 (CC2), U12.14 (CC2), U14.7 (CC2S)
/AUX Port/AUX Type C Controller/VCONN: C51.1, R32.1, TP37.1 (1_1), U12.12 (VCONN), U12.13 (VCONN)
/AUX Port/AUX_SBU1: U14.2 (SBU2C); also elsewhere on the board
/AUX Port/AUX_SBU2: U14.1 (SBU1C); also elsewhere on the board
/AUX Port/AUX_TYPE_C.SBU1S: U14.9 (SBU2S); also elsewhere on the board
/AUX Port/AUX_TYPE_C.SBU2S: U14.10 (SBU1S); also elsewhere on the board
/AUX Port/AUX_TYPE_C.SCL: R38.2, U12.6 (SCL); also elsewhere on the board
/AUX Port/AUX_TYPE_C.SDA: R33.2, U12.7 (SDA); also elsewhere on the board
/AUX Port/AUX_TYPE_C.~FAULT: R99.2, U14.6 (FAULTB); also elsewhere on the board
/AUX Port/AUX_TYPE_C.~INT: R39.2, U12.5 (INT_N); also elsewhere on the board
GND: C49.2, C51.2, C52.2, C53.2, C58.2, C63.2, U12.8 (GND), U12.9 (GND), U12.15 (GND), U14.11 (GND), U14.13 (GND); also elsewhere on the board
unnamed: C63.1, U14.5 (CB)

Parts of its further copies:
C41, C56: 1uF; C_0402_1005Metric; Part Number CL05A105MQ5NNNC
C45, C57: 0.1uF; C_0402_1005Metric; Part Number CL05A104KA5NNNC
C54, C55: 330pF; C_0402_1005Metric; Part Number CL05C331JB5NNNC
R36: 0; R_0402_1005Metric; Part Number RC0402FR-070RL
R37, R100: 10k; R_0402_1005Metric; Part Number RC0402JR-0710KL
R97, R98: 2.2k; R_0402_1005Metric; Part Number RC0402JR-072K2L
TP36: TestPoint; TestPoint_Pad_D1.0mm
U2: FUSB302B; WQFN-14-1EP_2.5x2.5mm_P0.5mm_EP1.45x1.45mm; Part Number FUSB302BMPX
U13: DPO2036; Diodes_UQFN2020-12_Type-B; Part Number DPO2036DBB-7

Connections of its further copies:
+3V3: C41.1, C56.1, R36.2, R37.1, R97.1, R98.1, R100.1, U2.3 (VDD), U2.4 (VDD), U13.12 (VSYS); also elsewhere on the board
/FPGA Banks 0 and 1/TARGET_C.SBU1S: U13.10 (SBU1S); also elsewhere on the board
/FPGA Banks 0 and 1/TARGET_C.SBU2S: U13.9 (SBU2S); also elsewhere on the board
/FPGA Banks 0 and 1/TARGET_C.SCL: R98.2, U2.6 (SCL); also elsewhere on the board
/FPGA Banks 0 and 1/TARGET_C.SDA: R97.2, U2.7 (SDA); also elsewhere on the board
/FPGA Banks 0 and 1/TARGET_C.~FAULT: R100.2, U13.6 (FAULTB); also elsewhere on the board
/FPGA Banks 0 and 1/TARGET_C.~INT: R37.2, U2.5 (INT_N); also elsewhere on the board
/TARGET Port/TARGET PHY/VBUS_CLAMPED: U2.2 (VBUS); also elsewhere on the board
/TARGET Port/TARGET Type C Controller/CC1: C54.1, U13.3 (CC1C); also elsewhere on the board
/TARGET Port/TARGET Type C Controller/CC1S: U2.10 (CC1), U2.11 (CC1), U13.8 (CC1S)
/TARGET Port/TARGET Type C Controller/CC2: C55.1, U13.4 (CC2C); also elsewhere on the board
/TARGET Port/TARGET Type C Controller/CC2S: U2.1 (CC2), U2.14 (CC2), U13.7 (CC2S)
/TARGET Port/TARGET Type C Controller/SBU1: U13.1 (SBU1C); also elsewhere on the board
/TARGET Port/TARGET Type C Controller/SBU2: U13.2 (SBU2C); also elsewhere on the board
/TARGET Port/TARGET Type C Controller/VCONN: C45.1, R36.1, TP36.1 (1_1), U2.12 (VCONN), U2.13 (VCONN)
GND: C41.2, C45.2, C54.2, C55.2, C56.2, C57.2, U2.8 (GND), U2.9 (GND), U2.15 (GND), U13.11 (GND), U13.13 (GND); also elsewhere on the board
unnamed: C57.1, U13.5 (CB)

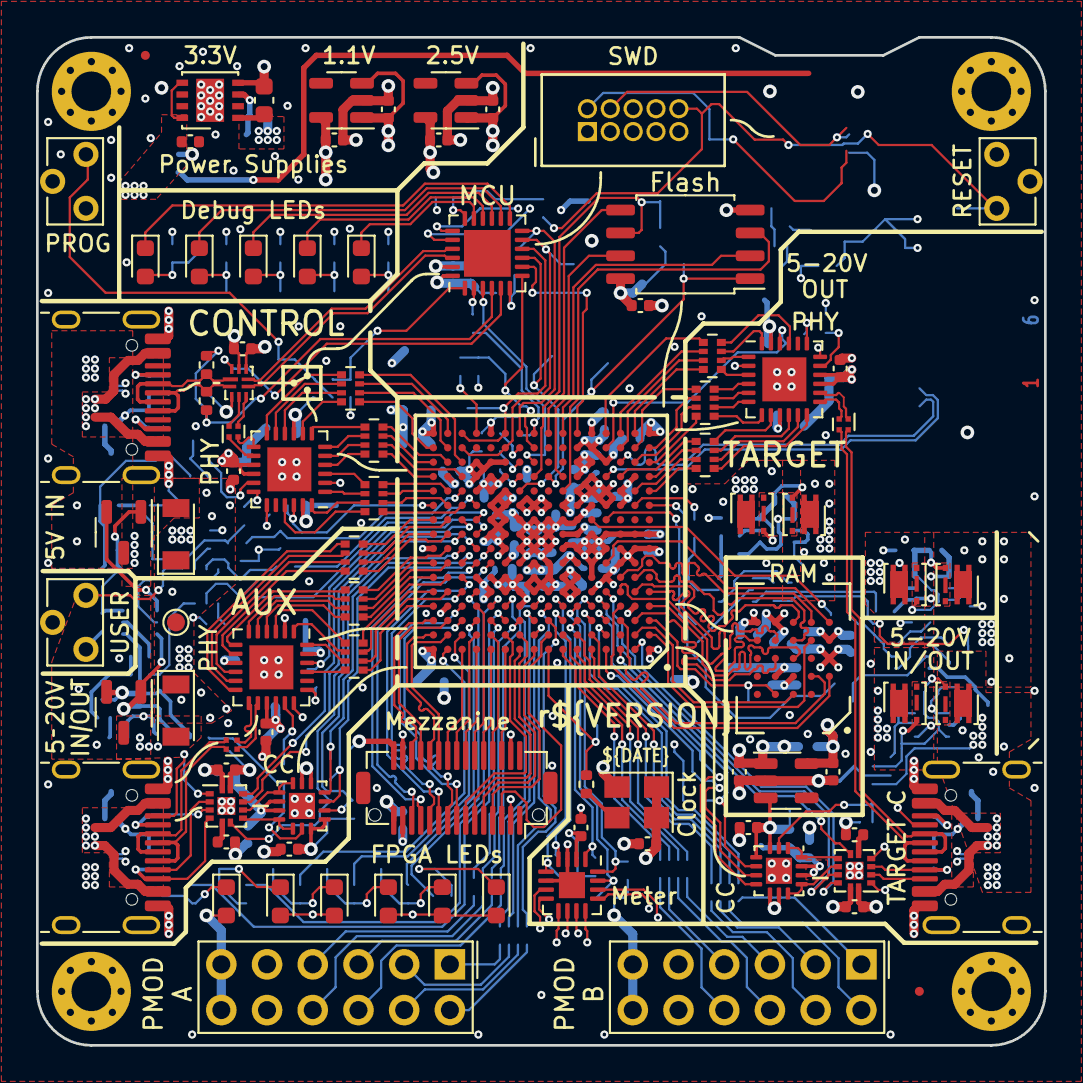
[picture p18: board cynthion.kicad_pcb from above]

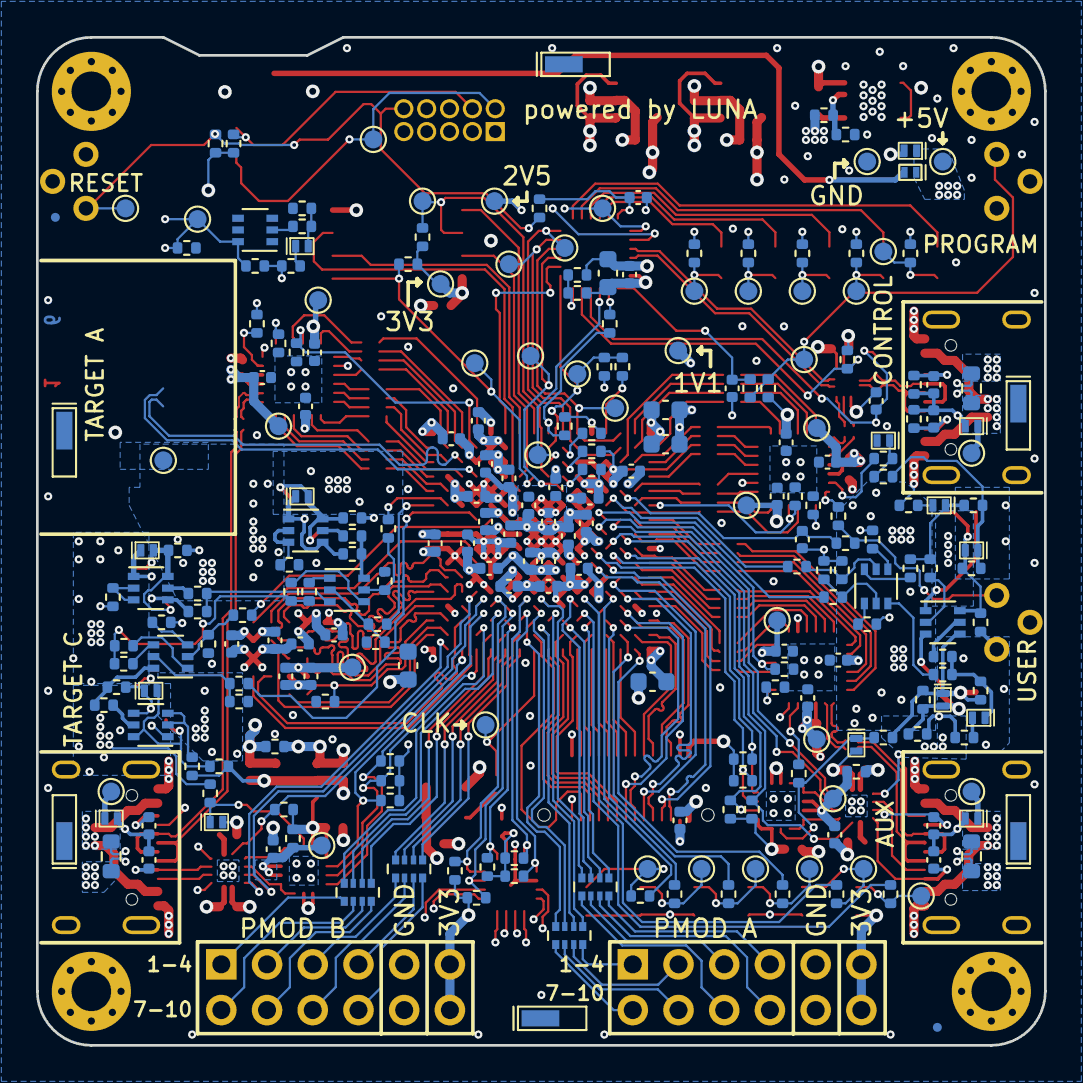
[picture p19: board cynthion.kicad_pcb from below]

Board: 6 copper layers, 56.0 x 56.0 mm, 341 parts (249 on the bottom side), 329 nets.

Other parts of the board:
D9: SCHOTTKY; DSN1006-2

Their connections:
+5V: D9.1 (K); also elsewhere on the board
