awtoau/awto-cynthion-hardware/(notices)

Notices in the files:
parts and their libraries:
COPYRIGHT: Copyright 2019-2024 Great Scott Gadgets
LICENSE: Licensed under the CERN-OHL-P v2
